BrentWilkins/rocket-workbench/docs-evidence/runs/cfd-corrected-surface-audit-20260913/report.md

# CFD pilot audit

Completed flow solution is not accepted design evidence.

Solver completed: True. Last iteration: 600. Last-100-sample settling screen: True. Zero-angle lateral/moment symmetry
screen: False.

| Coefficient | Last-100 mean | Peak-to-peak |
| --- | --- | --- |
| Cd | 0.593827 | 0.000002 |
| Cl | 0.000646 | 0.000016 |
| Cs | 0.022699 | 0.000018 |
| CmPitch | -0.002960 | 0.000088 |
| CmRoll | -0.000579 | 0.000001 |
| CmYaw | 0.102051 | 0.000085 |

Axes are taken from the solver output, not assumed from input keywords. v2512 reports pitch about negative Z for this
drag/lift basis. No coefficients have been transferred to flight models. Grid/wall/domain checks and benchmark
comparison remain outstanding.
