BrentWilkins/rocket-workbench/docs-evidence/runs/fin-recovery-stress-summary-20260913/report.md

# Full recovery uncertainty comparison

Three designs × 288 deterministic cases = 864 flights. 192 planned dummy/logger and 96 diagnostic-empty cases per
design. These are not reliability probabilities. No CFD acceptance or physical launch clearance is implied.

| Design | Planned passes / 192 | Loaded altitude m | Loaded speed m/s | Loaded descent m/s |
| --- | --- | --- | --- | --- |
| delta-chute20-body430-nominal | 192 | 154.32–193.99 | 52.72–62.00 | 4.39–5.80 |
| delta-chute22-body460-nominal | 192 | 148.99–187.64 | 51.38–60.36 | 4.04–5.33 |
| delta-chute24-body500-nominal | 192 | 142.97–180.36 | 49.89–58.51 | 3.76–4.95 |

Inputs: nominal/upper avionics, mount mass ×1/1.5, printed mass ×1/1.2, payload CG ±5 mm, chute Cd 0.6/0.9, winds 0/2/4
m/s. Canopy mass and packed volume are provisional area-scaled estimates.
