BrentWilkins/rocket-workbench/docs-evidence/runs/fin-stress-20260913/report.md

# Fin finalist uncertainty comparison

Deterministic corners, not reliability probabilities. Dummy/logger planned; empty diagnostic. No flight clearance.

| Design | Upper avionics | Mount factor | Planned pass / 48 | Failure counts |
| --- | --- | --- | --- | --- |
| [trapezoidal-a45-b430](trapezoidal-a45-b430-upper0-mount1/stress-20260913T160857Z-1c177246/report.md) | False | 1.0 | 36 | {'landing_descent_m_s': 12} |
| [trapezoidal-a45-b430](trapezoidal-a45-b430-upper0-mount1.5/stress-20260913T160922Z-8180d281/report.md) | False | 1.5 | 20 | {'landing_descent_m_s': 24, 'minimum_ascent_stability_cal': 8} |
| [trapezoidal-a45-b430](trapezoidal-a45-b430-upper1-mount1/stress-20260913T160944Z-6b664524/report.md) | True | 1.0 | 24 | {'landing_descent_m_s': 24} |
| [trapezoidal-a45-b430](trapezoidal-a45-b430-upper1-mount1.5/stress-20260913T161008Z-c6a25181/report.md) | True | 1.5 | 24 | {'landing_descent_m_s': 24} |
| [elliptical-a55-b410](elliptical-a55-b410-upper0-mount1/stress-20260913T161038Z-3ba5412f/report.md) | False | 1.0 | 36 | {'landing_descent_m_s': 12} |
| [elliptical-a55-b410](elliptical-a55-b410-upper0-mount1.5/stress-20260913T161105Z-b08634cd/report.md) | False | 1.5 | 24 | {'landing_descent_m_s': 24} |
| [elliptical-a55-b410](elliptical-a55-b410-upper1-mount1/stress-20260913T161140Z-ebfc4f2c/report.md) | True | 1.0 | 24 | {'landing_descent_m_s': 24} |
| [elliptical-a55-b410](elliptical-a55-b410-upper1-mount1.5/stress-20260913T161203Z-02ca7021/report.md) | True | 1.5 | 24 | {'landing_descent_m_s': 24} |
| [clipped-delta-a45-b410](clipped-delta-a45-b410-upper0-mount1/stress-20260913T161230Z-215af76f/report.md) | False | 1.0 | 36 | {'landing_descent_m_s': 12} |
| [clipped-delta-a45-b410](clipped-delta-a45-b410-upper0-mount1.5/stress-20260913T161255Z-e73950df/report.md) | False | 1.5 | 24 | {'landing_descent_m_s': 24} |
| [clipped-delta-a45-b410](clipped-delta-a45-b410-upper1-mount1/stress-20260913T161319Z-885b2120/report.md) | True | 1.0 | 24 | {'landing_descent_m_s': 24} |
| [clipped-delta-a45-b410](clipped-delta-a45-b410-upper1-mount1.5/stress-20260913T161342Z-355af603/report.md) | True | 1.5 | 24 | {'landing_descent_m_s': 24} |
| [clipped-delta-a45-b430](clipped-delta-a45-b430-upper0-mount1/stress-20260913T161404Z-97cb0a8c/report.md) | False | 1.0 | 36 | {'landing_descent_m_s': 12} |
| [clipped-delta-a45-b430](clipped-delta-a45-b430-upper0-mount1.5/stress-20260913T161428Z-2a7e5a03/report.md) | False | 1.5 | 24 | {'landing_descent_m_s': 24} |
| [clipped-delta-a45-b430](clipped-delta-a45-b430-upper1-mount1/stress-20260913T161452Z-0759a5cc/report.md) | True | 1.0 | 24 | {'landing_descent_m_s': 24} |
| [clipped-delta-a45-b430](clipped-delta-a45-b430-upper1-mount1.5/stress-20260913T161519Z-eef21873/report.md) | True | 1.5 | 24 | {'landing_descent_m_s': 24} |
| [swept-a45-b410](swept-a45-b410-upper0-mount1/stress-20260913T161546Z-51bf399e/report.md) | False | 1.0 | 36 | {'landing_descent_m_s': 12} |
| [swept-a45-b410](swept-a45-b410-upper0-mount1.5/stress-20260913T161616Z-b25ae19c/report.md) | False | 1.5 | 24 | {'landing_descent_m_s': 24} |
| [swept-a45-b410](swept-a45-b410-upper1-mount1/stress-20260913T161640Z-08345981/report.md) | True | 1.0 | 24 | {'landing_descent_m_s': 24} |
| [swept-a45-b410](swept-a45-b410-upper1-mount1.5/stress-20260913T161708Z-79132db7/report.md) | True | 1.5 | 24 | {'landing_descent_m_s': 24} |
