BrentWilkins/rocket-workbench/docs-evidence/runs/insert-wide-summary-20260913/report.md

# Expanded recovery uncertainty comparison

288 deterministic flights; 192 planned dummy/logger and 96 empty diagnostics per design. Scenario counts are not
reliability probabilities.

Bounds: print mass ×1/1.2, payload CG ±5 mm, wind 0/2/4 m/s, chute Cd 0.53/1.04, mount mass ×1/1.5. Upper avionics and
+20% chute mass are paired, not independently varied. Generic packing remains provisional; sourced chute mass is a
literature specimen, not our hardware.

| Design | Planned passes / 192 | Altitude m | Speed m/s | Descent m/s | Drift m |
| --- | --- | --- | --- | --- | --- |
| apogee24-body500-heavy0-cd053-insert-trial | 192 | 144.64–186.62 | 50.33–60.29 | 3.45–5.24 | 0.04–163.02 |

Drift is horizontal landing displacement from the pad under the modeled uniform winds. It is not a landing-zone
guarantee. CFD, final retention hardware and physical validation remain separate.

Insert-trial upper profiles add 0.7 g to the nominal joint allowance, paired with upper avionics/chute mass. These are
unmeasured engineering allowances, not tested joint strength.
