BrentWilkins/rocket-workbench/docs-evidence/runs/ring-tail-geometry-step-20260913/report.md

# Ring-tail geometry comparison

Experimental 1.2 mm wall rings joining three clipped-delta tips. No flight-performance ranking, structural qualification
or print release. Native planar OpenRocket models do not represent the ring.

| Candidate | Added mass g | First-layer area mm² | Fits 236 mm square |
| --- | --- | --- | --- |
| planar-baseline | 0.000 | 420.4 | True |
| ring-tail-5mm | 3.551 | 993.2 | True |
| ring-tail-10mm  | 7.102 | 993.2 | True |

Mass is a CAD-density estimate. Ring area increases bed contact, but does not establish adhesion, impact tolerance or
aerodynamic benefit. External CFD and force/moment validation remain required.
