BrentWilkins/rocket-workbench/docs-evidence/runs/avionics-baseline-stress-20260913/report.md

# Current-avionics finalist uncertainty comparison

Each row: print mass 1.0/1.2, payload CG -5/+5 mm, chute Cd 0.6/0.9, winds 0/2/4 m/s, three loadings. Nominal and upper
avionics budgets are separate. Corner counts are not reliability probabilities.

| Design | Avionics g | Cases meeting gates | Loaded apogee range m | Loaded speed range m/s |
| --- | --- | --- | --- | --- |
| [conical-n50-b410-f55](conical-n50-b410-f55-nominal/stress-20260913T040714Z-27042adb/report.md) | 20.65 | 36/72 | 40.39–57.18 | 18.95–22.41 |
| [conical-n50-b410-f55](conical-n50-b410-f55-upper/stress-20260913T040736Z-ead8ec46/report.md) | 29.2 | 28/72 | 35.86–51.82 | 17.60–20.74 |
