BrentWilkins/rocket-workbench/docs-evidence/runs/fin-recovery-20260913/delta-chute24-body500-heavy/report.md

# Rocket Workbench report

Run: `delta-chute24-body500-heavy`

Provisional software demonstration. Physical assembly and flight validation are pending.

Configuration SHA256: `9ba0babb481d0958b2b8f0ed924b388f39b222cae05539b1101e2dd6c79a7ab2`

## Cases

| Case | Execution / evaluation | Apogee m | Guide m/s | Min ascent cal | Deploy m/s | Descent m/s | Drift m | Powered accel g | Estimated load g | Powered speed m/s |
| --- | --- | ---: | ---: | ---: | ---: | ---: | ---: | ---: | ---: | ---: |
| empty-D12-5-wind0  | completed / incomplete inputs | 178.85 | 12.83 | 1.82 | 2.56 | 4.62 | 0.08 | 12.95 | 13.95 | 58.09 |
| empty-D12-5-wind2  | completed / incomplete inputs | 177.09 | 12.82 | 1.14 | 3.66 | 4.62 | 53.05 | 12.94 | 13.94 | 57.95 |
| empty-D12-5-wind4  | completed / incomplete inputs | 172.39 | 12.82 | 1.16 | 6.42 | 4.62 |  105.32 | 12.93 | 13.93 | 57.56 |
| dummy-D12-5-wind0  | completed / incomplete inputs | 150.40 | 12.30 | 2.66 | 6.05 | 4.95 | 0.04 | 11.30 | 12.30 | 50.46 |
| dummy-D12-5-wind2  | completed / incomplete inputs | 148.43 | 12.30 | 2.02 | 6.71 | 4.95 | 33.34 | 11.29 | 12.29 | 50.31 |
| dummy-D12-5-wind4  | completed / incomplete inputs | 142.97 | 12.30 | 1.82 | 9.87 | 4.95 | 64.41 | 11.29 | 12.29 | 49.89 |
| actual-D12-5-wind0 | completed / incomplete inputs | 150.40 | 12.30 | 2.66 | 6.05 | 4.95 | 0.04 | 11.30 | 12.30 | 50.46 |
| actual-D12-5-wind2 | completed / incomplete inputs | 148.43 | 12.30 | 2.02 | 6.71 | 4.95 | 33.34 | 11.29 | 12.29 | 50.31 |
| actual-D12-5-wind4 | completed / incomplete inputs | 142.97 | 12.30 | 1.82 | 9.87 | 4.95 | 64.41 | 11.29 | 12.29 | 49.89 |

No case is ranked or cleared for flight. Dummy and provisional actual loads use the same mass and CG.

## Warnings and failures

- empty-D12-5-wind0: no engine warnings
- empty-D12-5-wind2: no engine warnings
- empty-D12-5-wind4: no engine warnings
- dummy-D12-5-wind0: no engine warnings
- dummy-D12-5-wind2: no engine warnings
- dummy-D12-5-wind4: no engine warnings
- actual-D12-5-wind0: no engine warnings
- actual-D12-5-wind2: no engine warnings
- actual-D12-5-wind4: no engine warnings

## Missing measurements / physical checks

- Measured mass and balance: BT-60 cardboard airframe
- Measured mass and balance: Provisional commercial 24 mm mount assembly plus CD spacer
- Measured mass and balance: Provisional 24 inch parachute and lines
- Measured mass and balance: Kevlar leader, elastic harness, swivel and knots
- Measured mass and balance: Recovery wadding
- Measured mass and balance: Two paper launch lugs and adhesive
- Measured mass and balance: Bulkhead eye bolt, washers, nuts, sled screws and cable ties
- Measured mass and balance: Fin collar adhesive and tapered lip fillet
- Measured mass and balance: Flame-resistant bay shield and perimeter seal allowance
- Assembled mass/CG, print fit, attachment strength and recovery separation checks
- V2 saddle bond strength and adhesive mass require physical checks; saddle-specific aerodynamic drag is unresolved
- Avionics board/antenna/battery masses, stack clearances, retention, wiring and power must be measured; vendor CAD is
  not physical validation
- Static-port drilling/alignment, bulkhead and screw seals, pressure lag and aerodynamic pressure bias require
  bench/flight validation

## Per-case criterion failures

- empty-D12-5-wind0: no numeric criterion failures; consult warnings and missing inputs
- empty-D12-5-wind2: no numeric criterion failures; consult warnings and missing inputs
- empty-D12-5-wind4: no numeric criterion failures; consult warnings and missing inputs
- dummy-D12-5-wind0: no numeric criterion failures; consult warnings and missing inputs
- dummy-D12-5-wind2: no numeric criterion failures; consult warnings and missing inputs
- dummy-D12-5-wind4: no numeric criterion failures; consult warnings and missing inputs
- actual-D12-5-wind0: no numeric criterion failures; consult warnings and missing inputs
- actual-D12-5-wind2: no numeric criterion failures; consult warnings and missing inputs
- actual-D12-5-wind4: no numeric criterion failures; consult warnings and missing inputs

## Assumptions and boundaries

- Length origin: nose tip, +x aft; CAD +Z maps to axial +x. Flight position: OpenRocket local east/north/up, SI units.
- ISA atmosphere, constant wind at every height, zero turbulence; configured seed is retained. Displacement is
  scenario-dependent.
- Native OpenRocket aerodynamics; configured axisymmetric nose, cylindrical sections, three flat trapezoidal fins and
  tapered collar fairing. The thin fairing lip/glue fillet is an approximation documented in BUILD.md.
- CAD volume × material density is a solid-mass estimate. Nose/bay/sled lumped mass and CG; fin mass included once in
  collar override.
- No external camera/antenna is modeled. Configuration rejects protrusions. An internal camera has no guaranteed useful
  view.
- Stability minimum is sampled from guide departure strictly before apogee or deployment, whichever comes first, using
  (CP−CG)/reference diameter. Low-speed samples remain included; time, speed and angle at the minimum are in JSON.
- Event metrics interpolate adjacent samples at the engine event time. Landing descent is vertical speed at ground
  event, not a structural impact assessment.
- Powered peaks use positive-thrust samples from liftoff strictly before first burnout, deployment, abort or ground
  contact. Missing events/data yield unavailable metrics; peak times and sample coverage are in JSON. These are sampled
  single-stage maxima, not continuous-time bounds.
- Powered acceleration is trajectory acceleration magnitude / 9.80665. Estimated load is hypot(lateral acceleration,
  vertical acceleration + local gravity) / 9.80665 at the center of mass. Coriolis correction, sensor-offset rotation,
  vibration and deployment/impact shock are excluded; this is not a per-axis IMU prediction or a hardware survival
  rating.
- Recovery is motor-ejection deployment with configured Cd; packing envelope, ejection seal, thermal protection and
  attachment loads require physical checks.
- Reference mode preserves upstream geometry and masses; demonstration CAD and baseline mass assumptions do not apply to
  that reference.

## Configured criteria

- apogee_m: 30.0 … None m; engineering assumption; New motor comparison: report altitude without inherited 120 m
  ceiling; retain 30 m minimum. Site altitude clearance is unassessed.
- guide_departure_m_s: 12.0 … None m/s; engineering assumption; Project engineering assumption for demonstration
  screening; not a launch clearance
- minimum_ascent_stability_cal: 1.0 … None cal; engineering assumption; Project engineering assumption for demonstration
  screening; not a launch clearance
- deployment_speed_m_s: None … 10.0 m/s; engineering assumption; Project engineering assumption for demonstration
  screening; not a launch clearance
- landing_descent_m_s: None … 6.0 m/s; engineering assumption; Project engineering assumption for demonstration
  screening; not a launch clearance

## Reproducibility

```json
{
  "openrocket": "24.12",
  "java": "21.0.3+7-LTS-152",
  "python": "3.14.6",
  "bridge_revision": "fb132c49e661bb00c5586cce6a4ac0c655425197",
  "jar_sha256": "4959b72f52f5f607941e9722abbb7b7f0c4a38ebbbf84204a329db9f31c4f897",
  "packages": {
    "orhelper": "0.1.5",
    "jpype1": "1.7.1",
    "numpy": "2.5.3",
    "pydantic": "2.13.5",
    "cadquery": "2.8.0"
  },
  "repository_revision": "2ca06e7f9c7adcd40d8e6847452df77f6a5b9717"
}
```

Exact motor curves, events and time series are retained in results.json. Null means unavailable; failures remain in the
table.
