BrentWilkins/rocket-workbench/docs-evidence/runs/avionics-geometry-20260913-corrected/conical-n50-b440-f55/report.md

# Rocket Workbench report

Run: `conical-n50-b440-f55`

Provisional software demonstration. Physical assembly and flight validation are pending.

Configuration SHA256: `02cb2b9dbd6d32880f0f9e05b9cc578a8937dd832cbc38b06a19166e590f08de`

## Cases

| Case | Execution / evaluation | Apogee m | Guide m/s | Min ascent cal |  Deploy m/s | Descent m/s | Drift m | Powered accel g | Estimated load g | Powered speed m/s |
| --- | --- | ---: | ---: | ---: | ---: | ---: | ---: | ---: | ---: | ---: |
| empty-A8-3-wind0  | completed / outside configured limits | 7.18 | 6.64 | 2.40 | unavailable | 10.74 | 0.34 | 5.36 | 6.36 | 8.43 |
| empty-A8-3-wind2  | completed / outside configured limits | 7.13 | 6.63 | 1.19 | unavailable | 10.08 | 0.24 | 5.36 | 6.36 | 8.40 |
| empty-B4-4-wind0  | completed / outside configured limits | 25.06 | 8.34 | 1.98 | 16.35 | 5.23 | 0.47 | 7.19 | 8.19 | 17.16 |
| empty-B4-4-wind2  | completed / outside configured limits | 24.21 | 8.33 | 1.35 | 20.19 | 15.13 | 9.70 | 7.19 | 8.19 | 16.92 |
| empty-C6-3-wind0  | completed / outside configured limits | 87.22 | 9.10 | 2.23 | 1.07 | 4.82 | 0.04 | 7.83 | 8.83 | 34.62 |
| empty-C6-3-wind2  | completed / outside configured limits | 83.17 | 9.09 | 1.62 | 6.19 | 4.82 | 5.53 | 7.83 | 8.83 | 34.45 |
| empty-C6-5-wind0  | completed / outside configured limits | 87.22 | 9.10 | 1.34 | 13.15 | 4.82 | 0.38 | 7.83 | 8.83 | 34.62 |
| empty-C6-5-wind2  | completed / outside configured limits | 83.17 | 9.09 | 1.62 | 19.21 | 4.82 | 13.59 | 7.83 | 8.83 | 34.45 |
| empty-C5-3-wind0  | completed / incomplete inputs | 71.18 | 13.05 | 2.05 | 4.84 | 4.83 | 0.00 | 11.84 | 12.84 | 26.59 |
| empty-C5-3-wind2  | completed / incomplete inputs | 69.41 | 13.05 | 1.68 | 5.94 | 4.83 | 11.02 | 11.83 | 12.83 | 26.42 |
| dummy-A8-3-wind0  | completed / outside configured limits | 5.26 | 5.71 | 2.84 | unavailable | 9.81 | 0.15 | 4.62 | 5.62 | 6.77 |
| dummy-A8-3-wind2  | completed / outside configured limits | 5.25 | 5.71 | 1.72 | unavailable | 9.34 | 0.24 | 4.62 | 5.62 | 6.76 |
| dummy-B4-4-wind0  | completed / outside configured limits | 18.97 | 7.37 | 2.84 | unavailable | 16.27 | 0.81 | 6.25 | 7.25 | 14.18 |
| dummy-B4-4-wind2  | completed / outside configured limits | 18.20 | 7.37 | 1.99 | unavailable | 18.08 | 8.19 | 6.25 | 7.25 | 13.93 |
| dummy-C6-3-wind0  | completed / outside configured limits | 69.77 | 8.16 | 2.66 | 2.47 | 5.14 | 0.03 | 6.84 | 7.84 | 29.38 |
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
