BrentWilkins/rocket-workbench/docs/assets/500-ogive-review/500-ogive-fin-detail.png

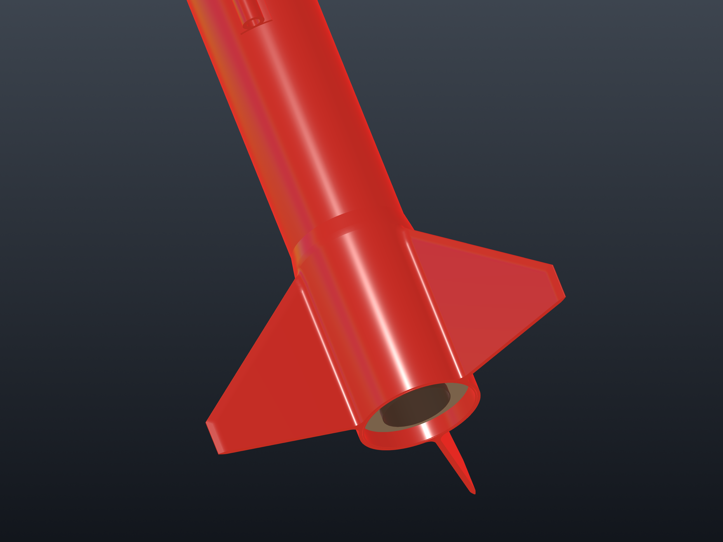
docs/assets/500-ogive-review/500-ogive-fin-detail.png
