BrentWilkins/rocket-workbench/docs/assets/500-ogive-review/500-ogive-streamlines-5120x1440.png

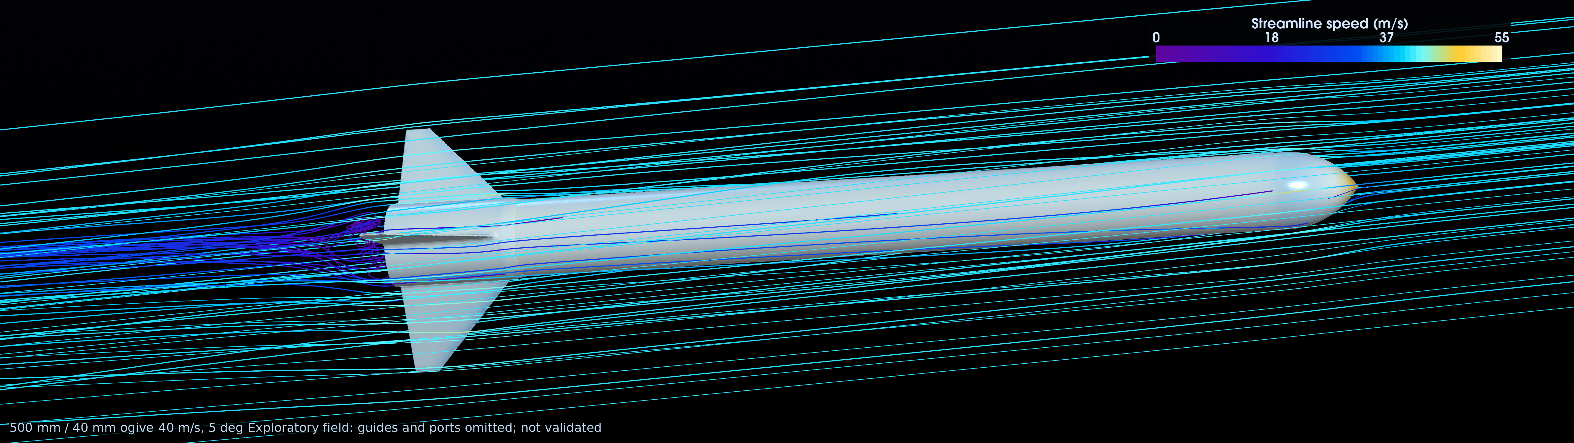
docs/assets/500-ogive-review/500-ogive-streamlines-5120x1440.png
