BrentWilkins/rocket-workbench/docs/assets/avionics/exploded.png

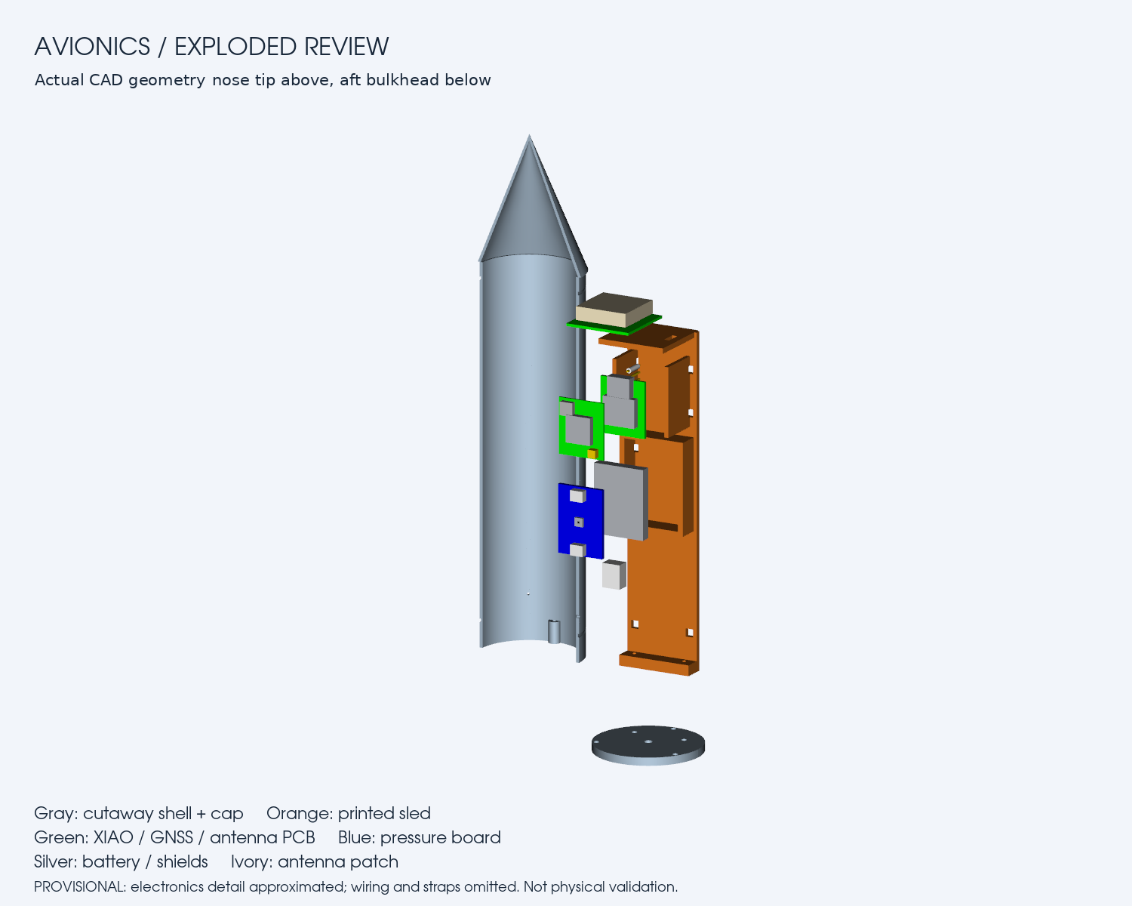
docs/assets/avionics/exploded.png
