BrentWilkins/rocket-workbench/docs/assets/cfd/swept-fin-desktop-hero.webp

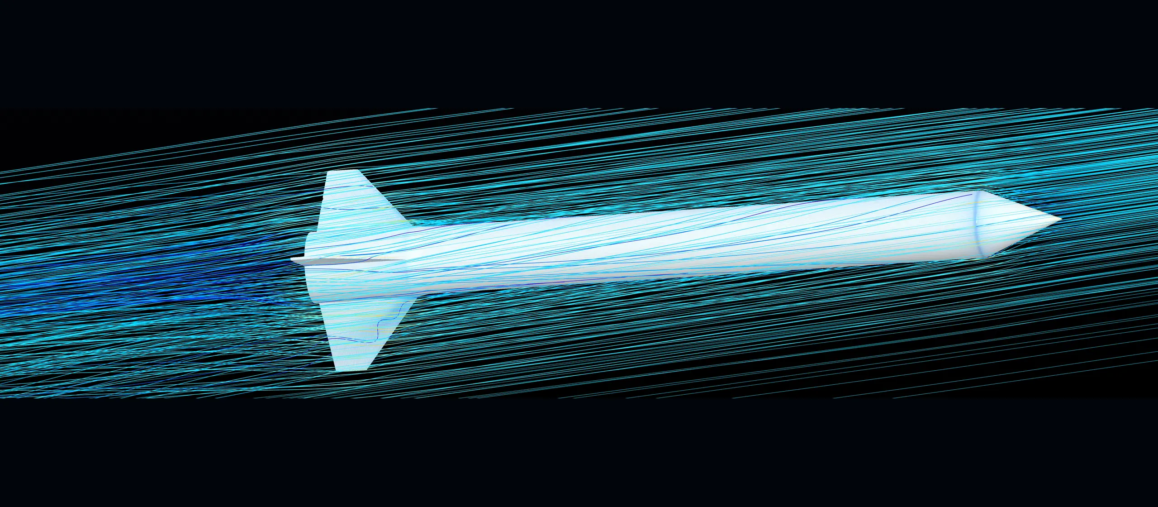
docs/assets/cfd/swept-fin-desktop-hero.webp
