BrentWilkins/rocket-workbench/docs/assets/fin-collar-v2/fin-collar-v2-review.png

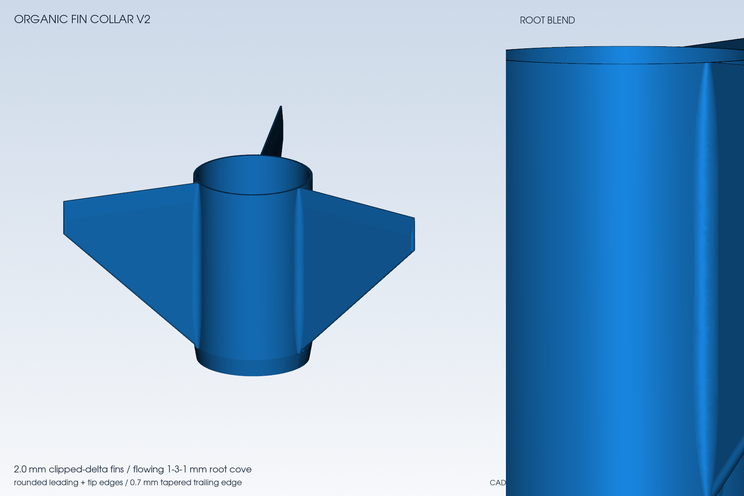
docs/assets/fin-collar-v2/fin-collar-v2-review.png
