BrentWilkins/rocket-workbench/docs/assets/flight-robustness/convergence.png

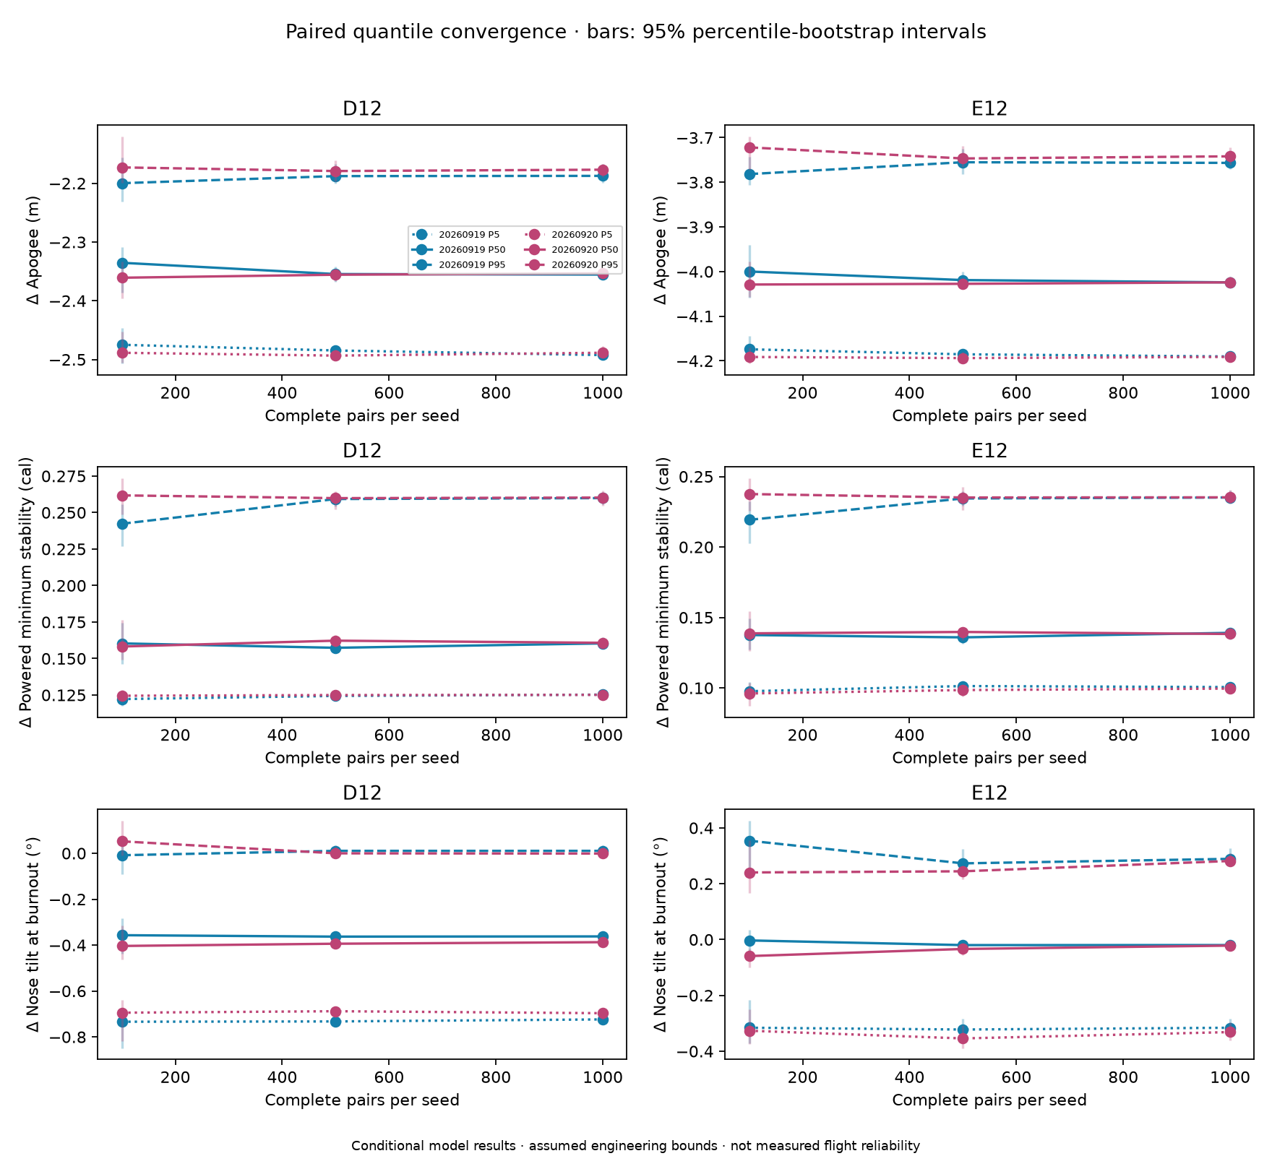
docs/assets/flight-robustness/convergence.png
