BrentWilkins/rocket-workbench/docs/assets/flight-robustness/deterministic.png

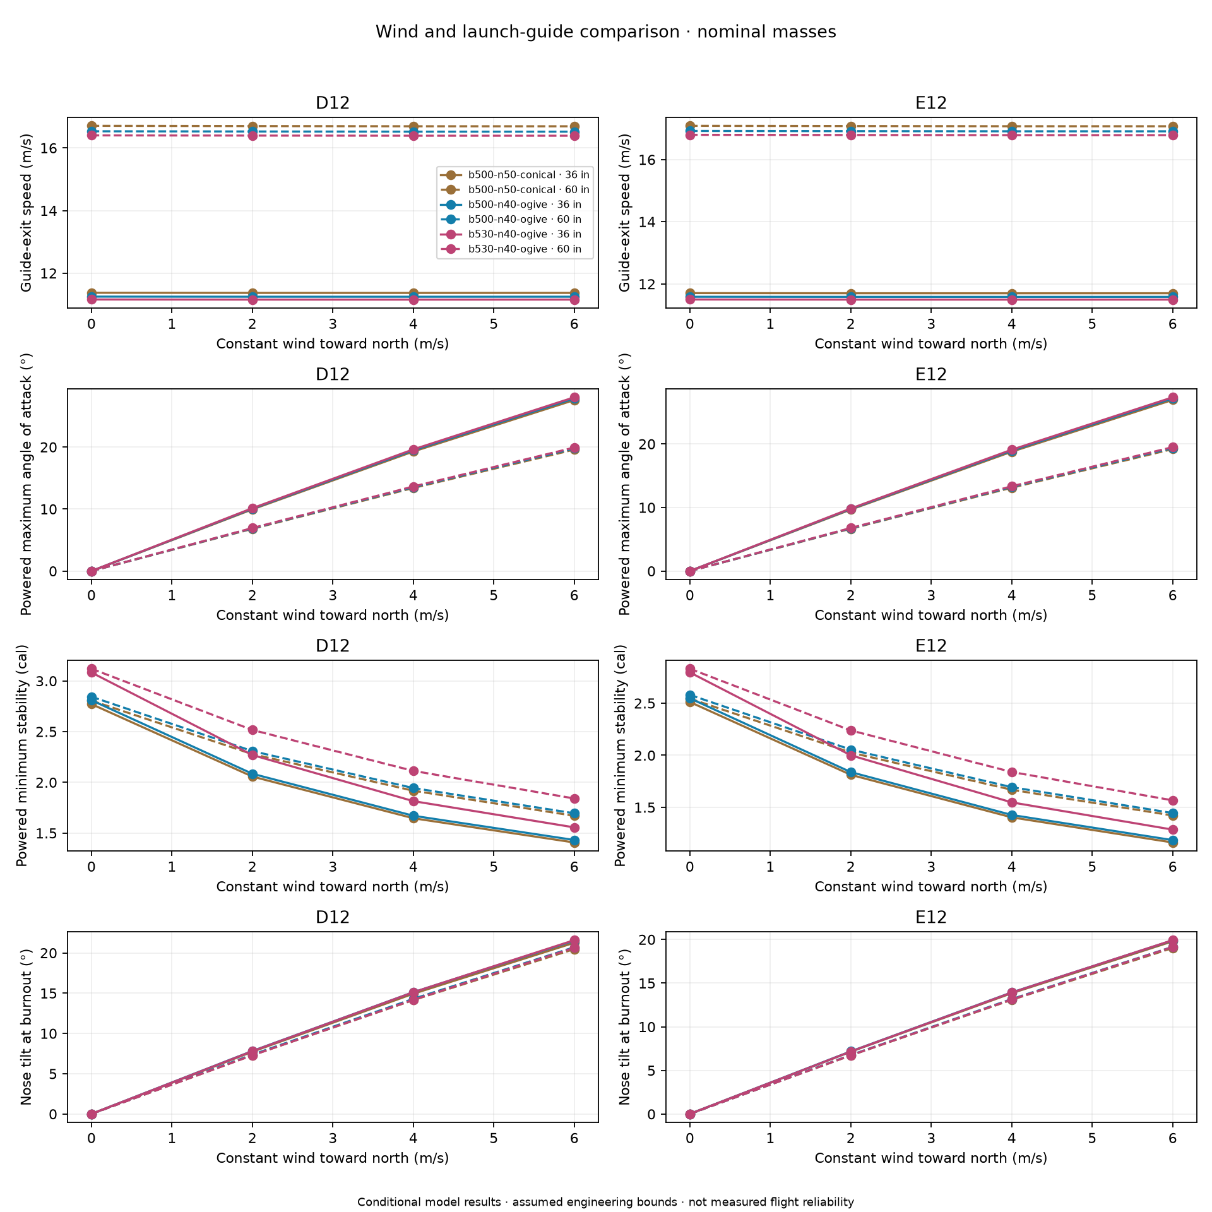
docs/assets/flight-robustness/deterministic.png
