BrentWilkins/rocket-workbench/docs/assets/flight-robustness/landing.png

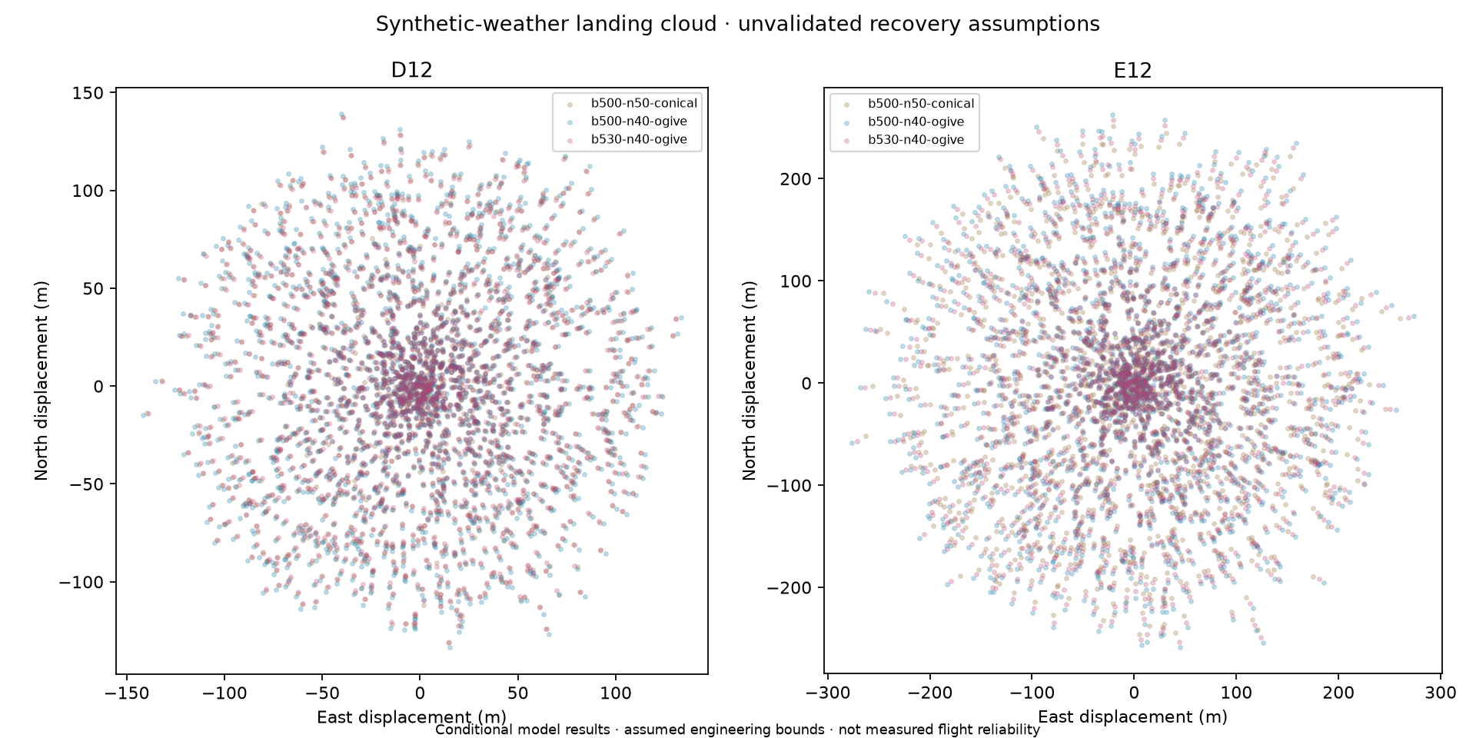
docs/assets/flight-robustness/landing.png
