BrentWilkins/rocket-workbench/docs/assets/flight-robustness/paired-differences.png

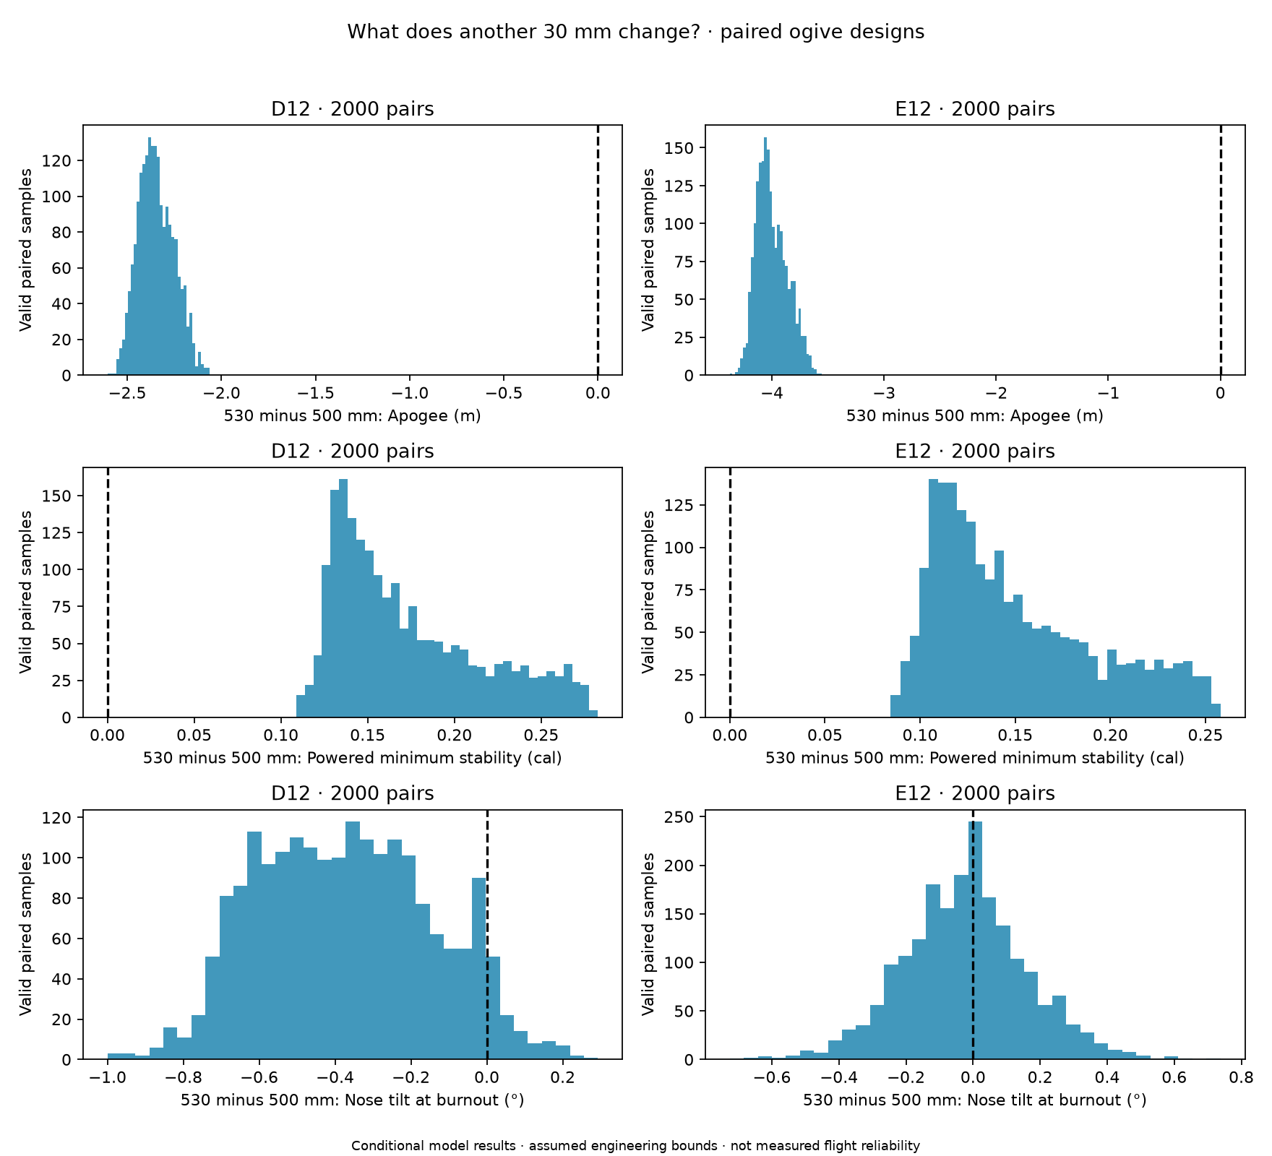
docs/assets/flight-robustness/paired-differences.png
