BrentWilkins/rocket-workbench/docs/assets/flight-robustness/paired-sensitivity.png

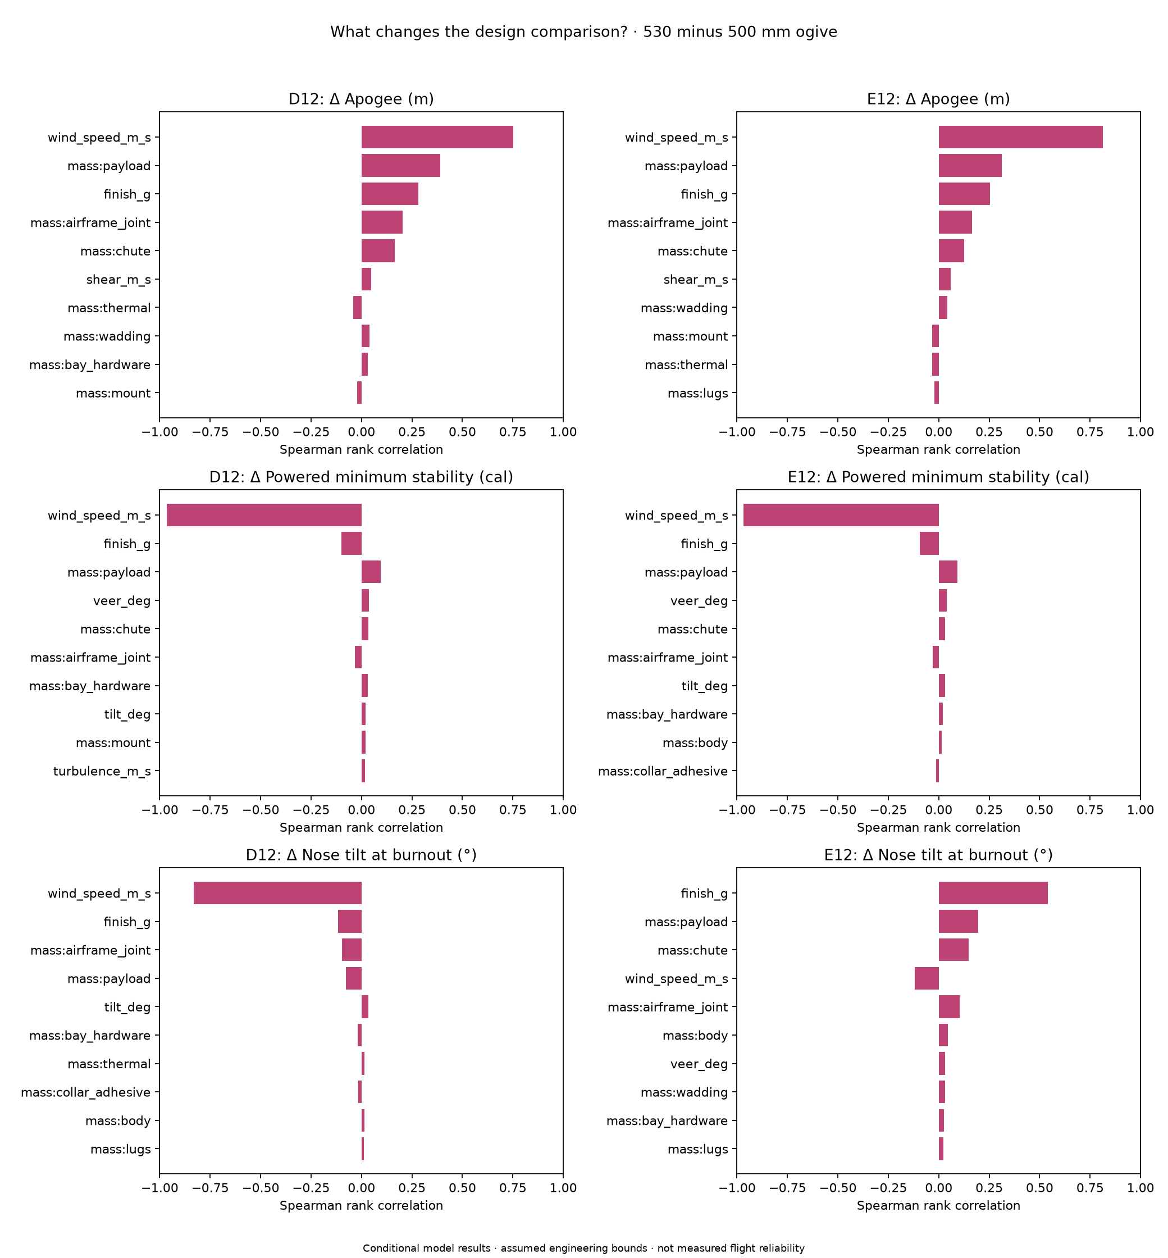
docs/assets/flight-robustness/paired-sensitivity.png
