BrentWilkins/rocket-workbench/docs/assets/flight-robustness/rocketpy-crosscheck.png

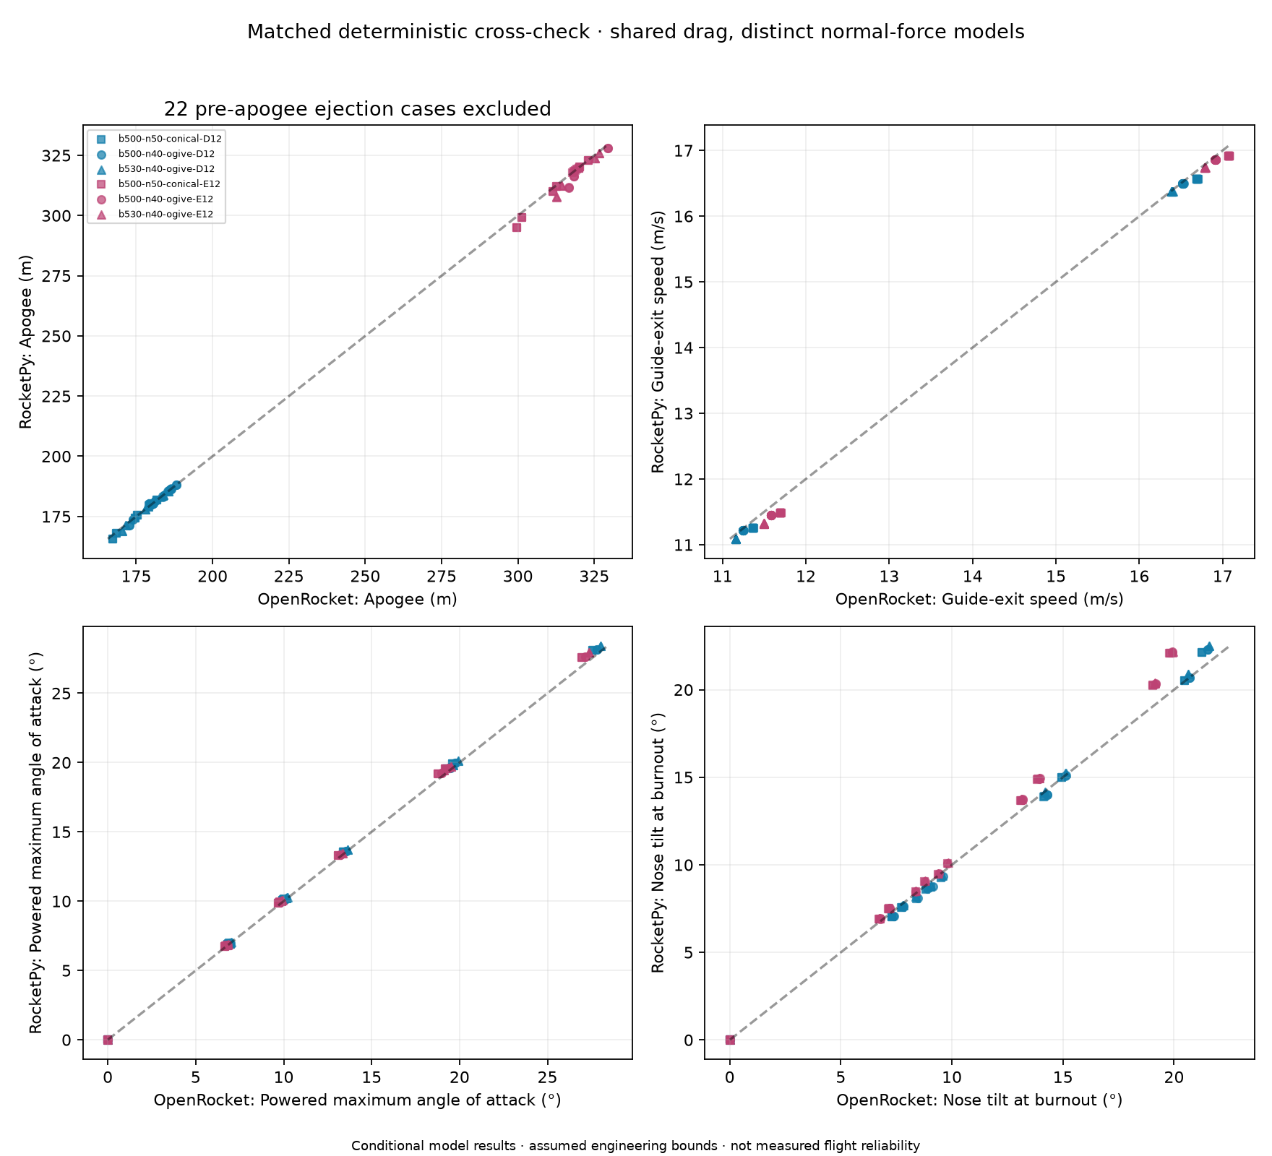
docs/assets/flight-robustness/rocketpy-crosscheck.png
