BrentWilkins/rocket-workbench/docs/assets/flight-robustness/sensitivity.png

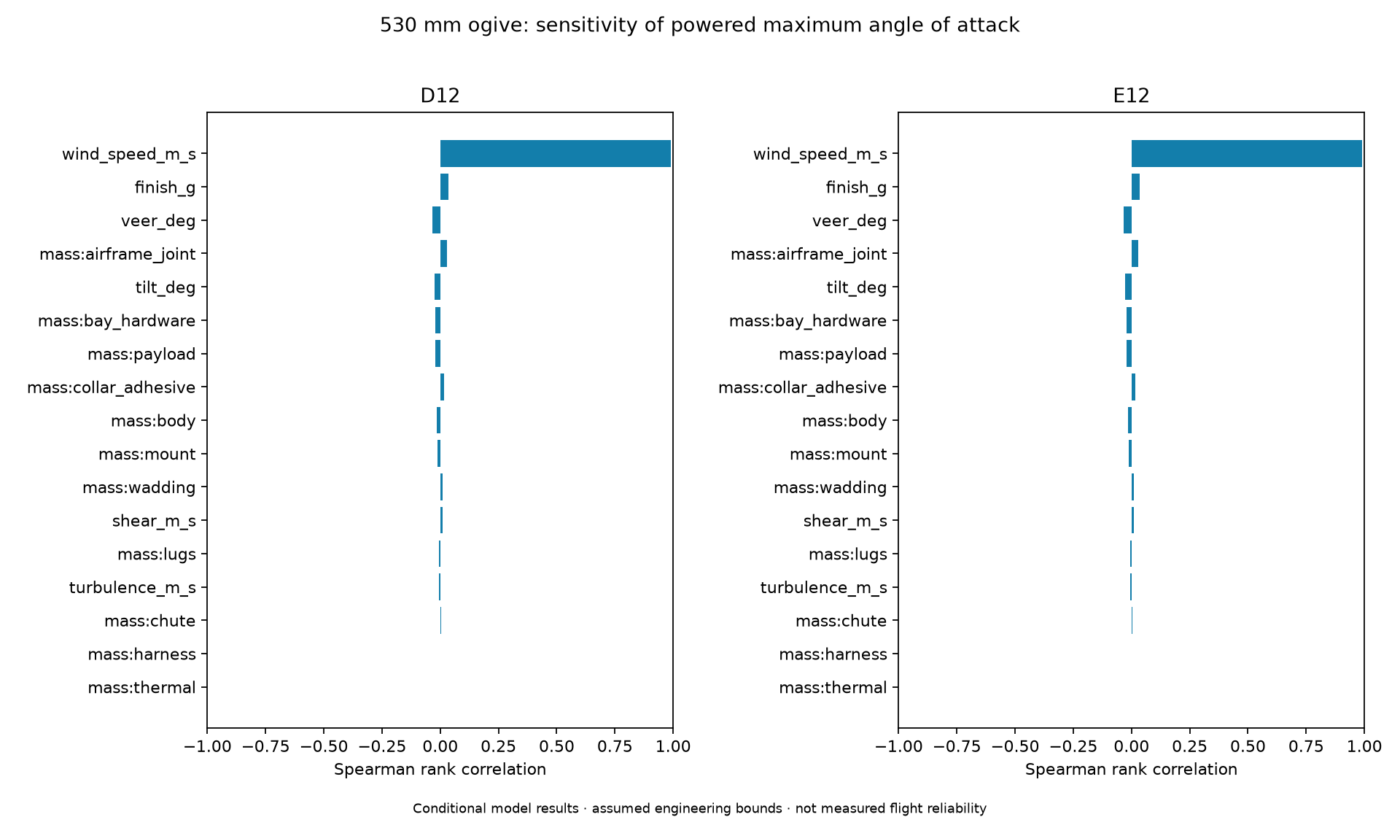
docs/assets/flight-robustness/sensitivity.png
