BrentWilkins/rocket-workbench/docs/assets/integrated-fin-collar-v1/integrated-fin-collar-preview.png

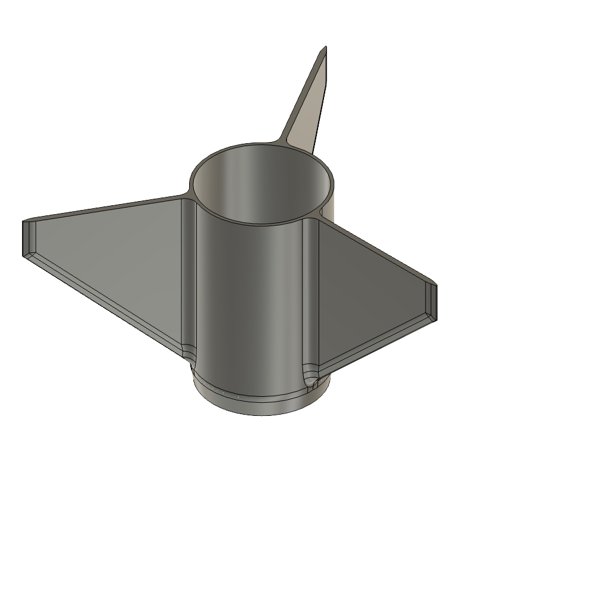
docs/assets/integrated-fin-collar-v1/integrated-fin-collar-preview.png
