BrentWilkins/rocket-workbench/docs/assets/payload-sweep/altitude-stability.png

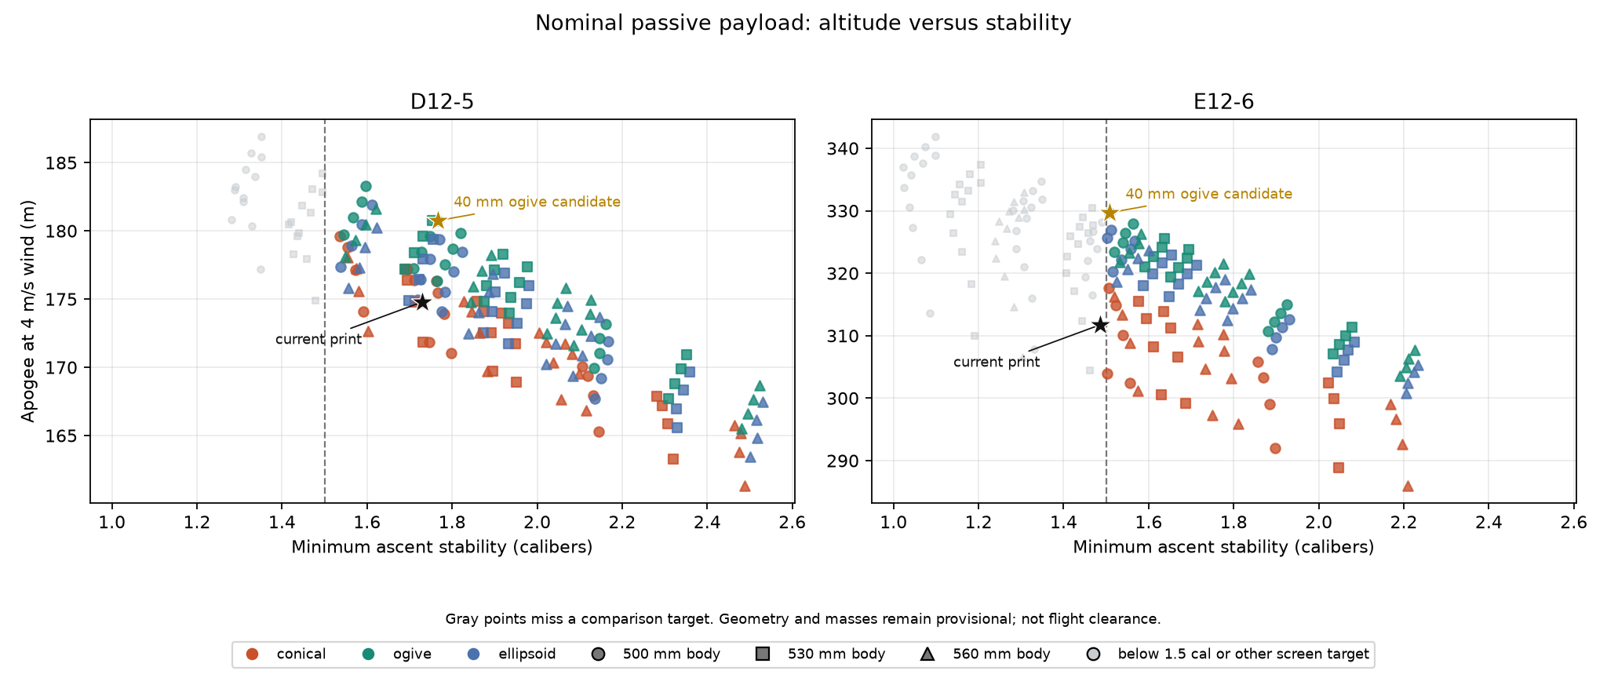
docs/assets/payload-sweep/altitude-stability.png
