BrentWilkins/rocket-workbench/docs/assets/payload-sweep/e12-geometry-map.png

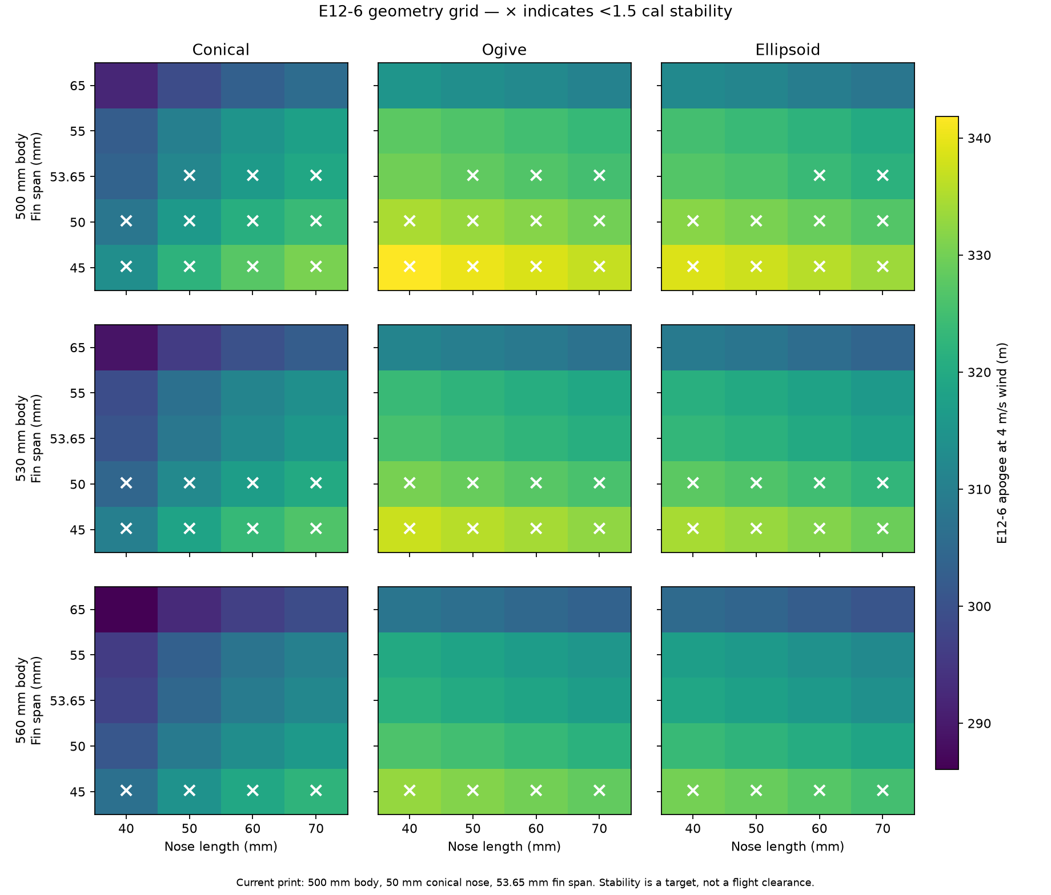
docs/assets/payload-sweep/e12-geometry-map.png
