BrentWilkins/rocket-workbench/docs/assets/payload-sweep/finished-mass-margins.png

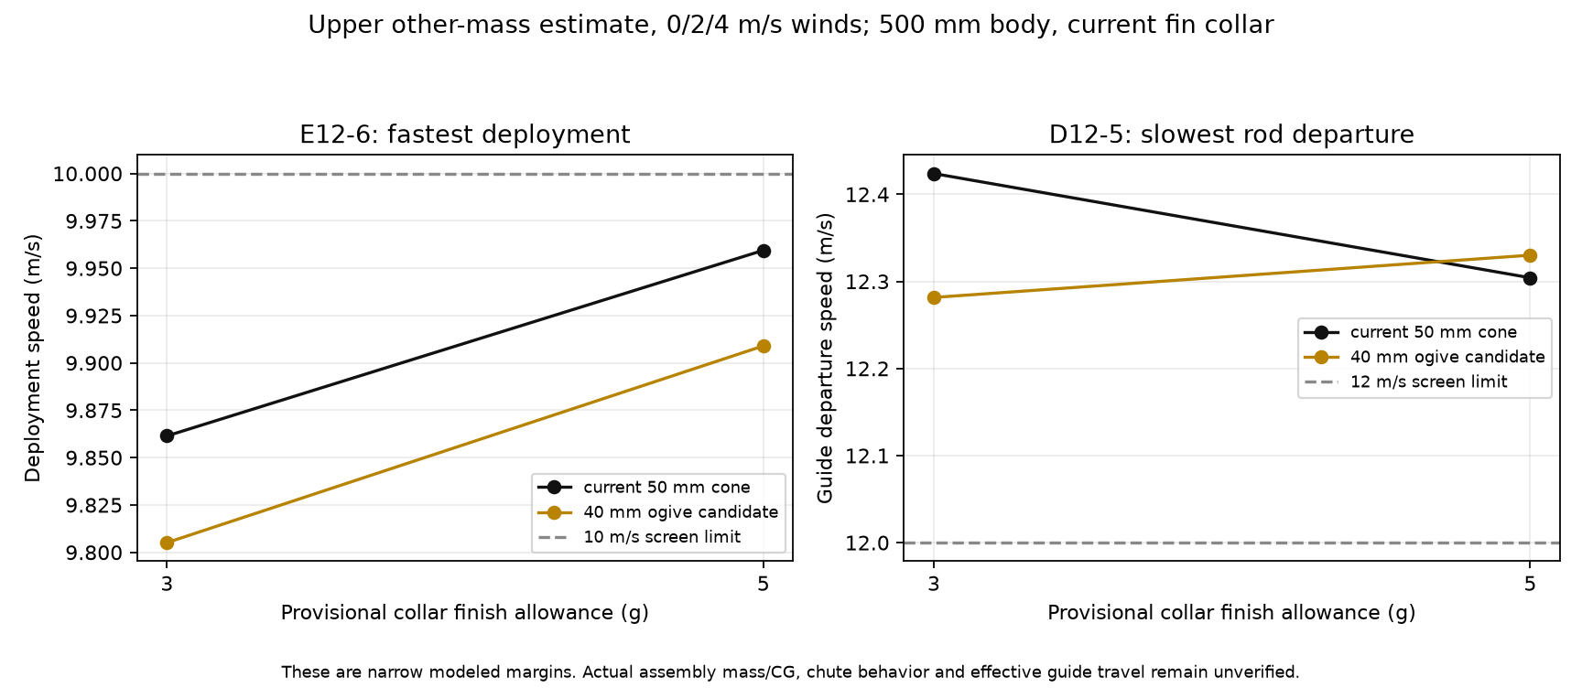
docs/assets/payload-sweep/finished-mass-margins.png
