BrentWilkins/rocket-workbench/docs/assets/payload-sweep/forward-additions.png

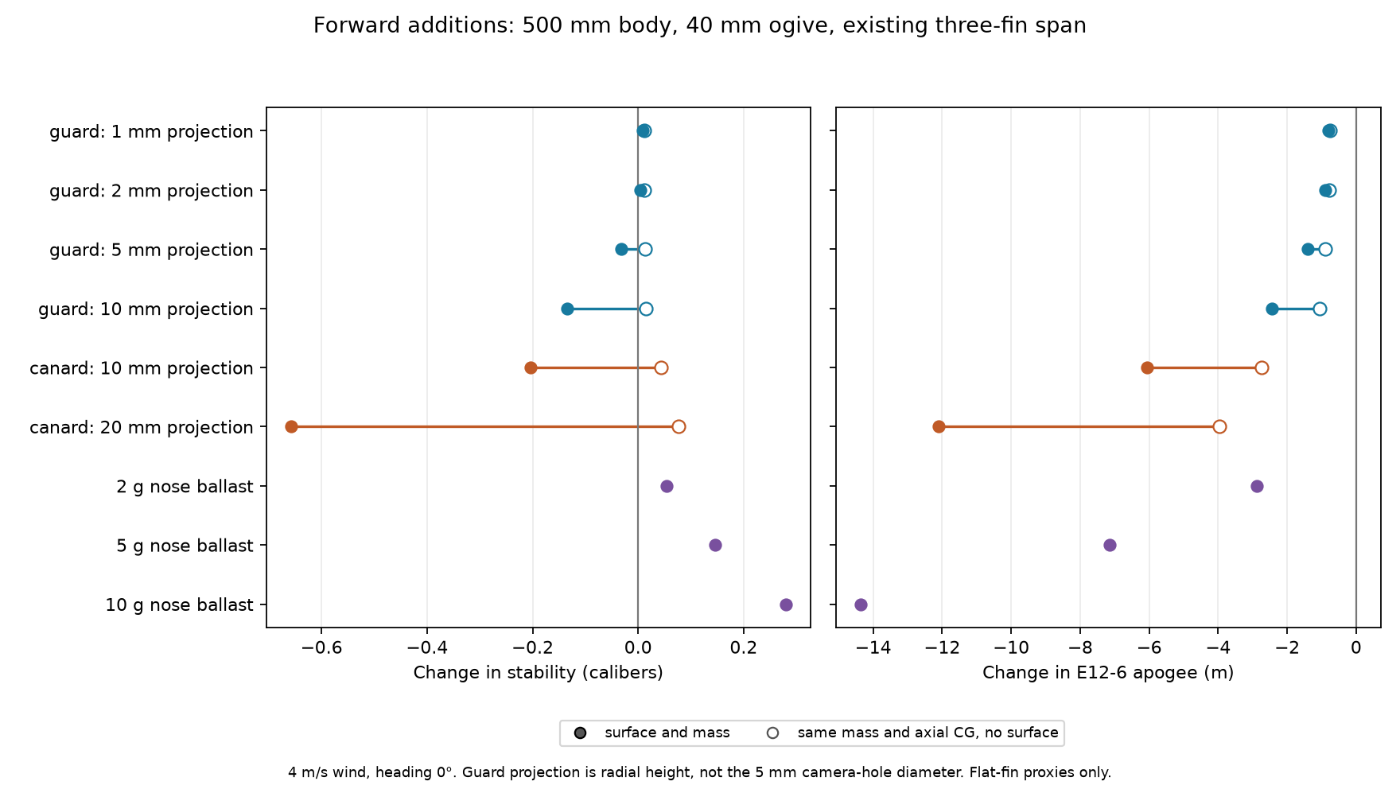
docs/assets/payload-sweep/forward-additions.png
