BrentWilkins/rocket-workbench/docs/assets/payload-sweep/nose-profiles.png

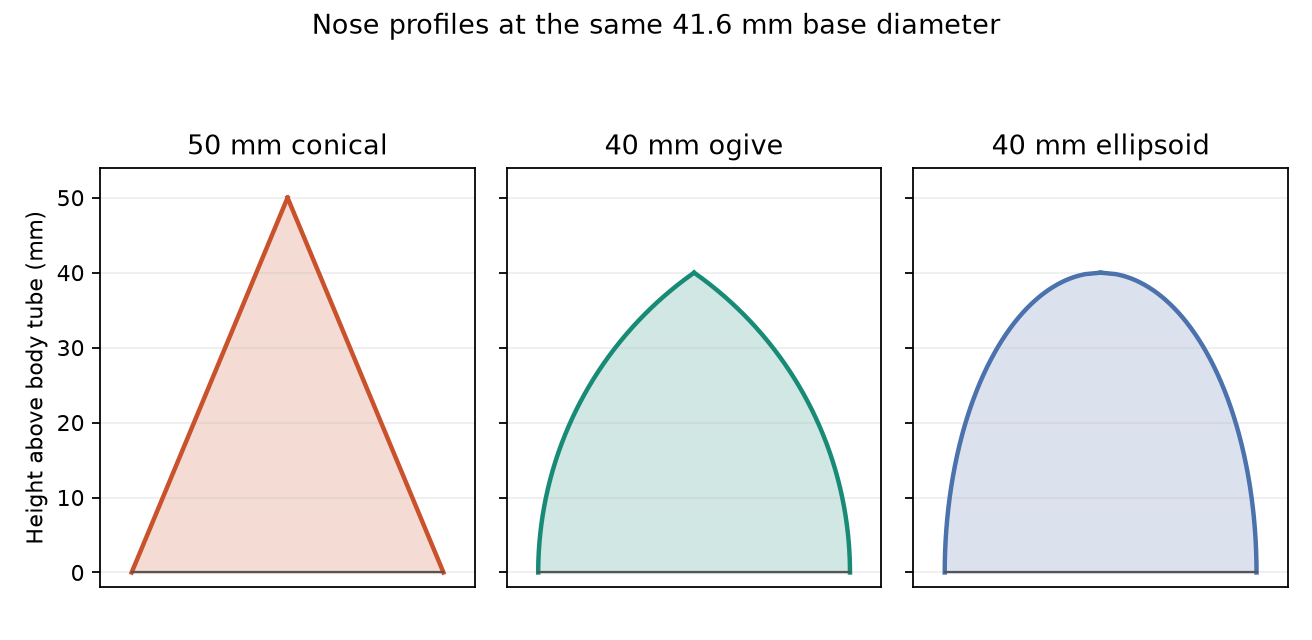
docs/assets/payload-sweep/nose-profiles.png
