BrentWilkins/rocket-workbench/docs/assets/payload-sweep/three-vs-four-fins.png

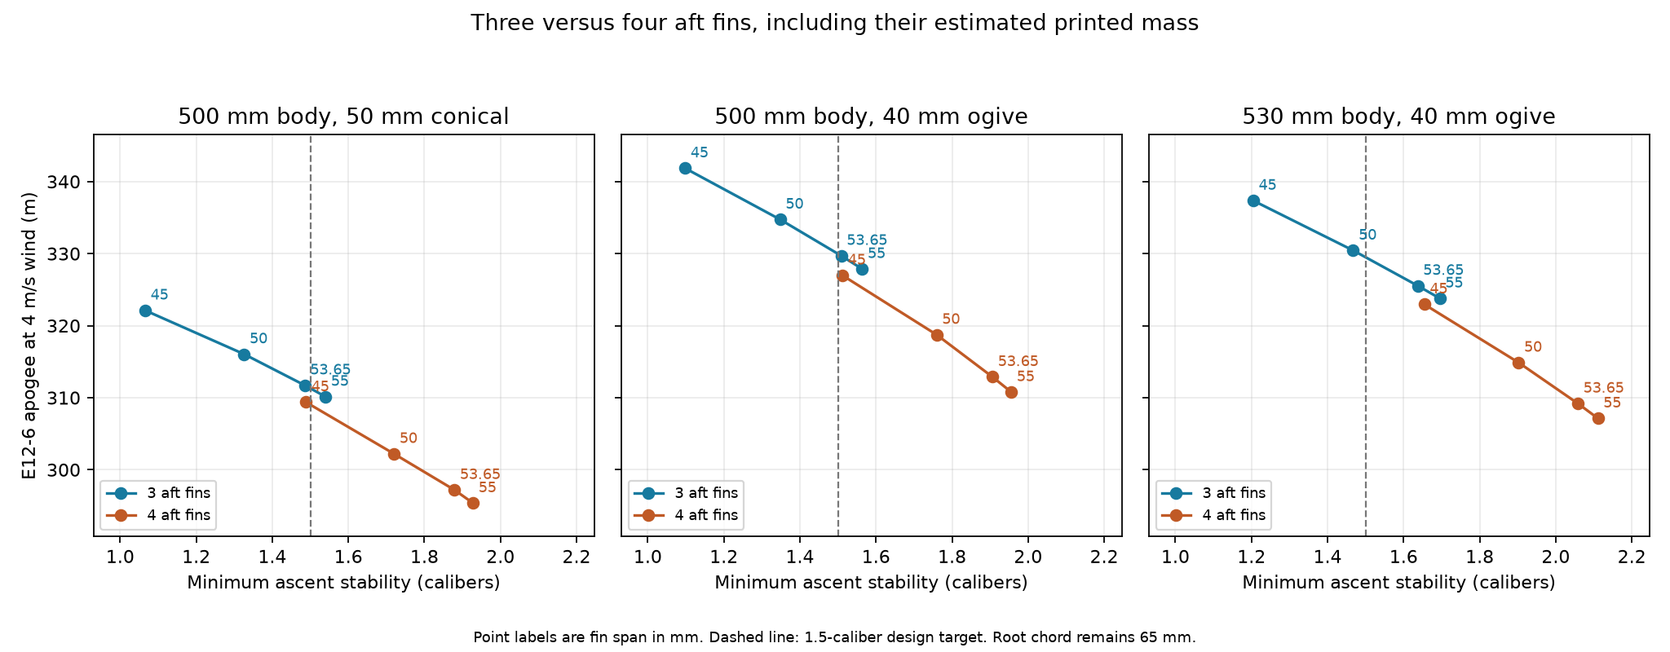
docs/assets/payload-sweep/three-vs-four-fins.png
