BrentWilkins/rocket-workbench/plots/de-geometry-same-motor.png

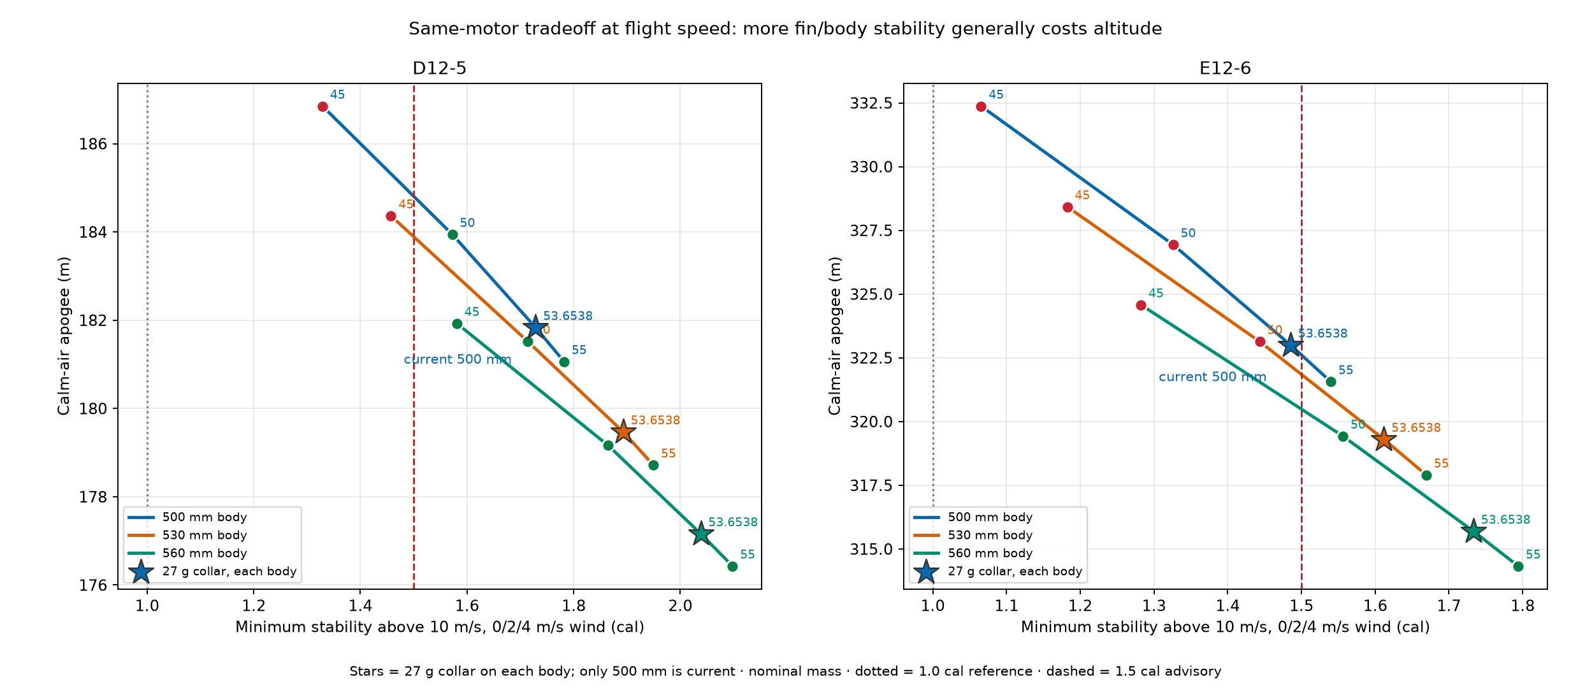
plots/de-geometry-same-motor.png
