BrentWilkins/rocket-workbench/plots/de-geometry-surface.png

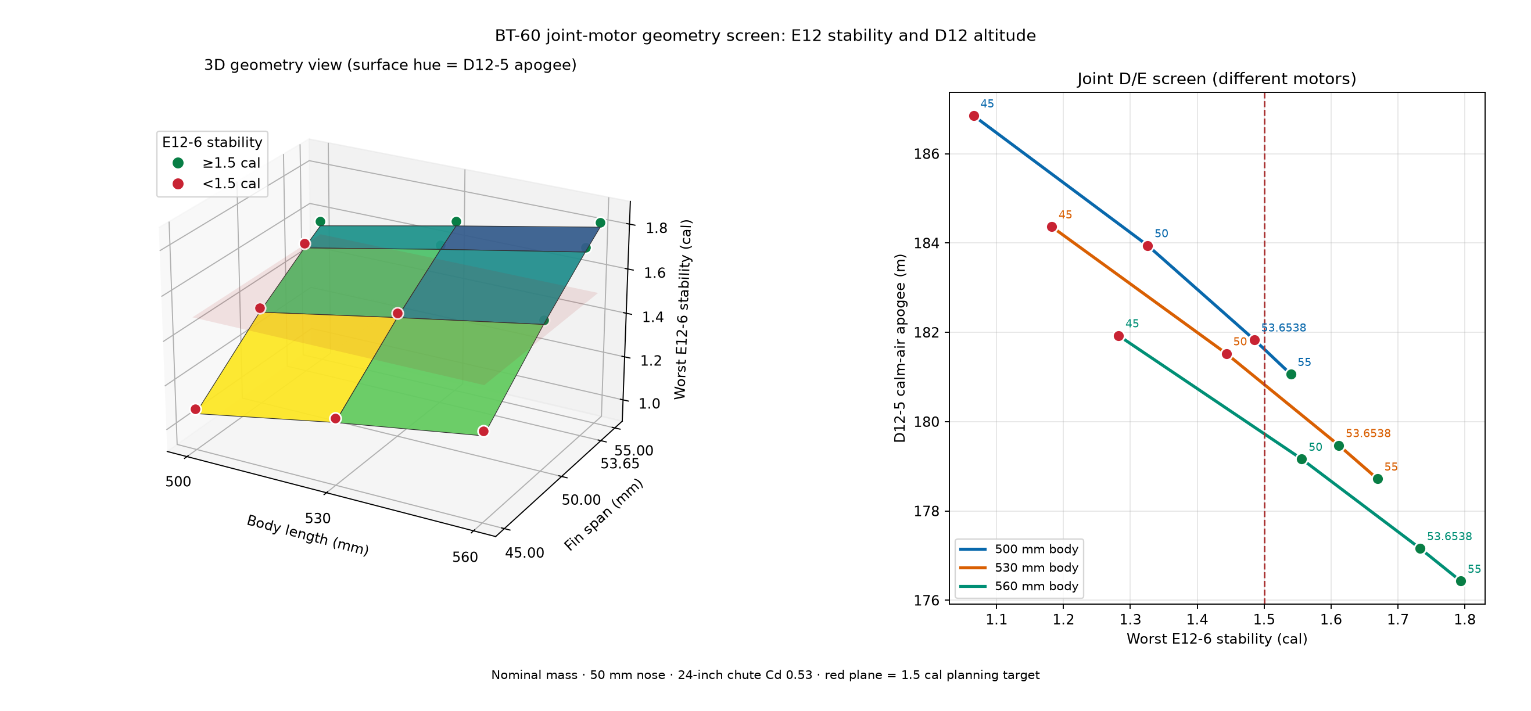
plots/de-geometry-surface.png
