BrentWilkins/rocket-workbench/plots/de-geometry-tradeoff.png

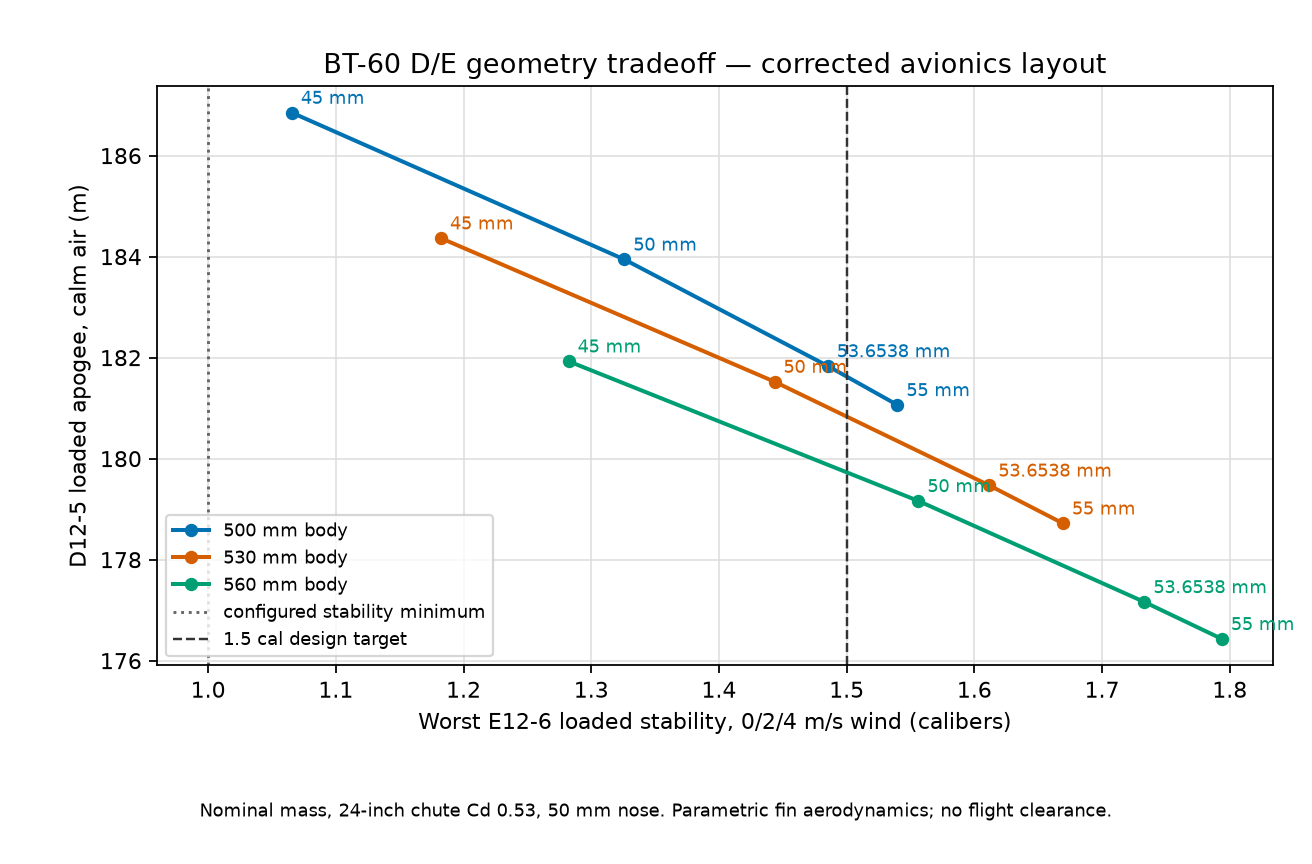
plots/de-geometry-tradeoff.png
