BrentWilkins/rocket-workbench/plots/ring-tail-comparison.png

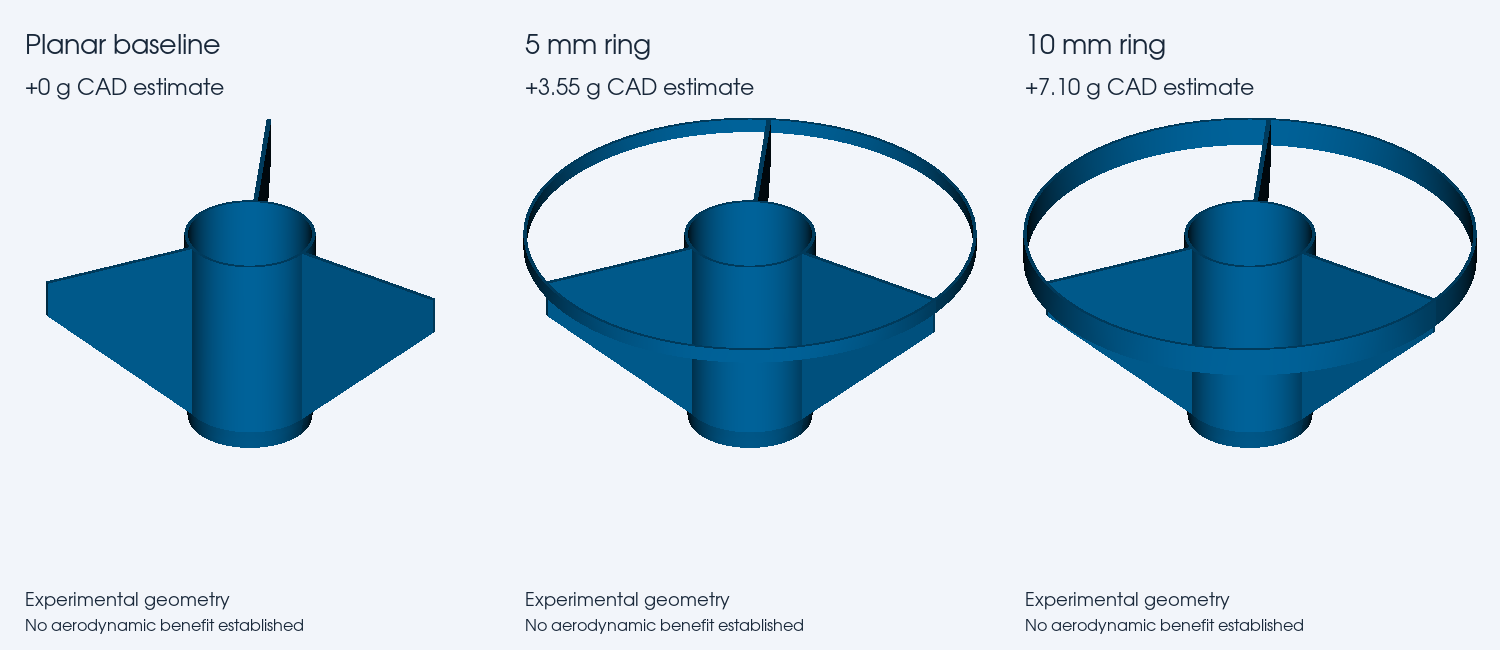
plots/ring-tail-comparison.png
