BrentWilkins/rocket-workbench/docs/assets/flight-robustness/flights.csv

phase | design | scenario | execution | warning_count | error | apogee_m | guide_departure_m_s | powered_min_stability_cal | minimum_ascent_stability_cal | powered_max_aoa_deg | burnout_tilt_deg | powered_max_pitch_yaw_rate_deg_s | deployment_speed_m_s | landing_displacement_m
deterministic | b500-n40-ogive-D12 | rod0.9144-wind0-heading0 | completed | 0 |  | 188.16396065363483 | 11.250998103175618 | 2.8095589329565893 | 2.2603660560675505 | 0.0009557095060873746 | 0.010082383562635916 | 0.0 | 0.7242327906039775 | 0.09250510230271908
deterministic | b500-n40-ogive-D12 | rod0.9144-wind2-heading0 | completed | 0 |  | 186.1290029987765 | 11.247290916465683 | 2.0848284426613093 | 2.0133507689629435 | 10.056926450072405 | 7.823043565495657 | 38.307771770064456 | 3.4531951192997306 | 48.86487700348473
deterministic | b500-n40-ogive-D12 | rod0.9144-wind2-heading90 | completed | 0 |  | 186.1317392318332 | 11.247290806386028 | 2.0848277757498592 | 2.018793266740356 | 10.05693860615839 | 7.83261863832892 | 38.31409565911605 | 3.471984146066718 | 48.780043124898235
deterministic | b500-n40-ogive-D12 | rod0.9144-wind4-heading0 | completed | 0 |  | 180.48514994898625 | 11.24655386676057 | 1.67107656248671 | 1.67107656248671 | 19.47368405740826 | 15.117752849744992 | 73.92346840367905 | 6.860411353194961 | 96.65441076142183
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
ensemble-20260919 | b500-n40-ogive-D12 | s20260919-0338 | completed | 0 |  | 170.78228780484946 | 11.104396415831324 | 1.674584417183063 | 1.674584417183063 | 17.564725143146784 | 13.696160128238356 | 67.82899728326035 | 6.84979392233036 | 67.33089152196456
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
