BrentWilkins/rocket-workbench/docs-evidence/runs/20260912T192553Z-candidate-recovery-7f53a228/cad/assembly.step

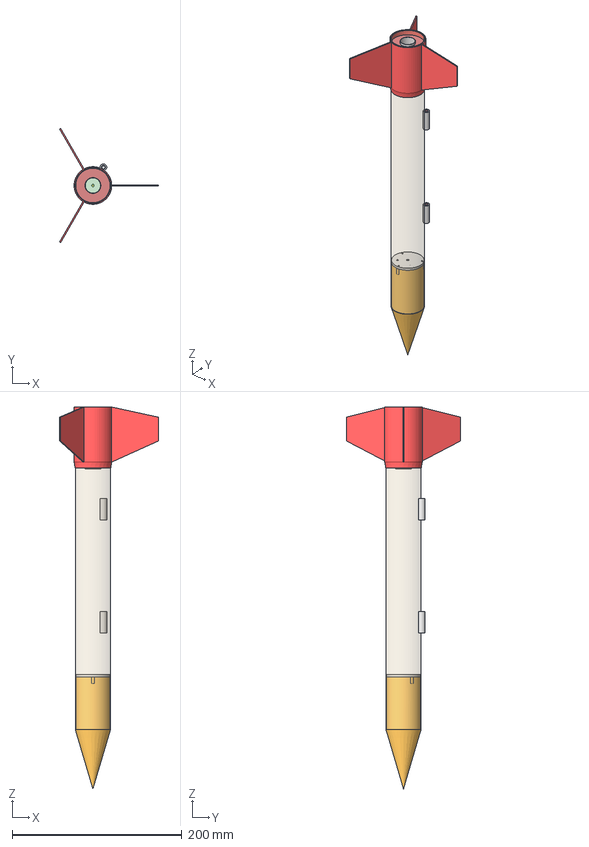
[picture p26: CAD file, 2026-09-12]
docs-evidence/runs/20260912T192553Z-candidate-recovery-7f53a228/cad/assembly.step
116.5 x 134.5 x 450.0 mm
nose-bay
bay-bulkhead
payload-sled
fin-collar
lug-sleeve-1
lug-sleeve-2
purchased-BT60
purchased-mount-envelope
purchased-centering-ring-envelope-0
purchased-centering-ring-envelope-1
packing-envelope-not-a-print
purchased-paper-lug-1
purchased-paper-lug-2
