BrentWilkins/rocket-workbench/docs-evidence/runs/avionics-geometry-20260913-corrected/ogive-n50-b440-f55/cad/assembly.step

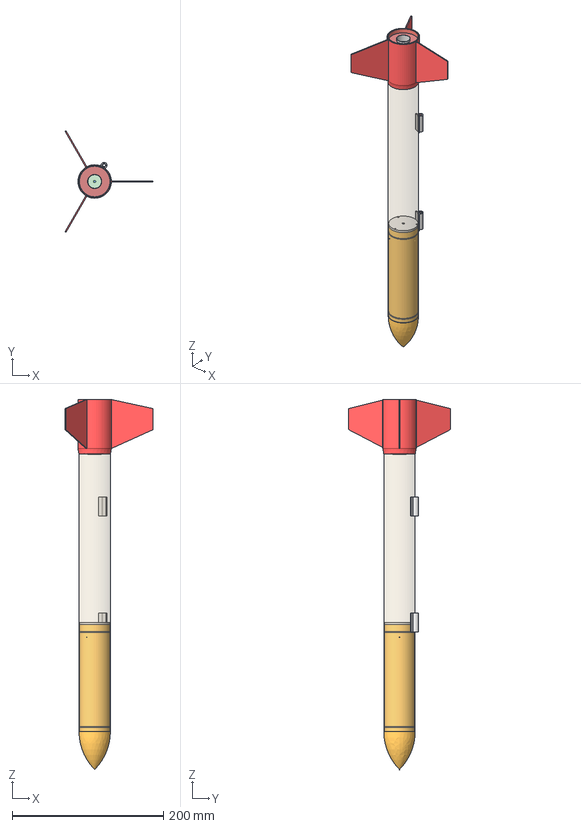
[picture p29: CAD file, 2026-09-13]
docs-evidence/runs/avionics-geometry-20260913-corrected/ogive-n50-b440-f55/cad/assembly.step
116.5 x 134.5 x 490.0 mm
nose-bay
bay-bulkhead
payload-sled
fin-collar
lug-sleeve-1
lug-sleeve-2
xiao-sense
l76k
antenna
battery
barometer
battery-connector
harness
retention
purchased-seal-envelope-0
purchased-seal-envelope-1
purchased-BT60
purchased-mount-envelope
purchased-centering-ring-envelope-0
purchased-centering-ring-envelope-1
packing-envelope-not-a-print
purchased-paper-lug-1
purchased-paper-lug-2
