BrentWilkins/rocket-workbench/docs/assets/tip-refinement-v3/cad/assembly.step

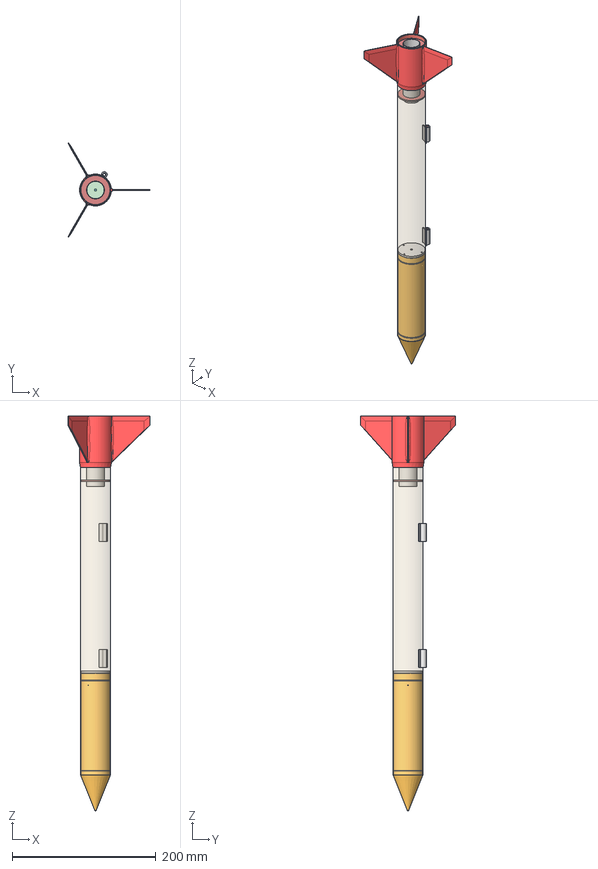
[picture p31: CAD file, 2026-09-20]
docs/assets/tip-refinement-v3/cad/assembly.step
114.1 x 131.7 x 550.0 mm
nose-bay
bay-bulkhead
payload-sled
fin-collar
lug-sleeve-1
lug-sleeve-2
xiao-sense
l76k
antenna
battery
barometer
battery-connector
harness
retention
purchased-seal-envelope-0
purchased-seal-envelope-1
purchased-BT60
purchased-mount-envelope
purchased-centering-ring-envelope-0
purchased-centering-ring-envelope-1
packing-envelope-not-a-print
purchased-paper-lug-1
purchased-paper-lug-2
