BrentWilkins/rocket-workbench/docs/assets/separate-fin-collar-v1/assembled-fit-reference.step

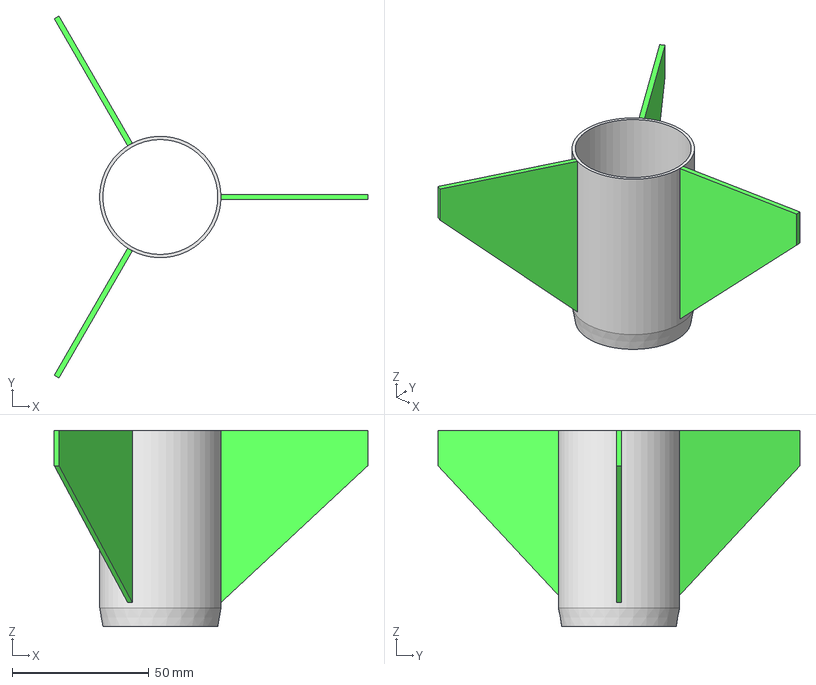
[picture p32: CAD file, 2026-09-20]
docs/assets/separate-fin-collar-v1/assembled-fit-reference.step
114.6 x 132.4 x 71.9 mm
round-collar
fin-0
fin-120
fin-240
