BrentWilkins/rocket-workbench/docs-evidence/prints/avionics-performance-v5.3mf

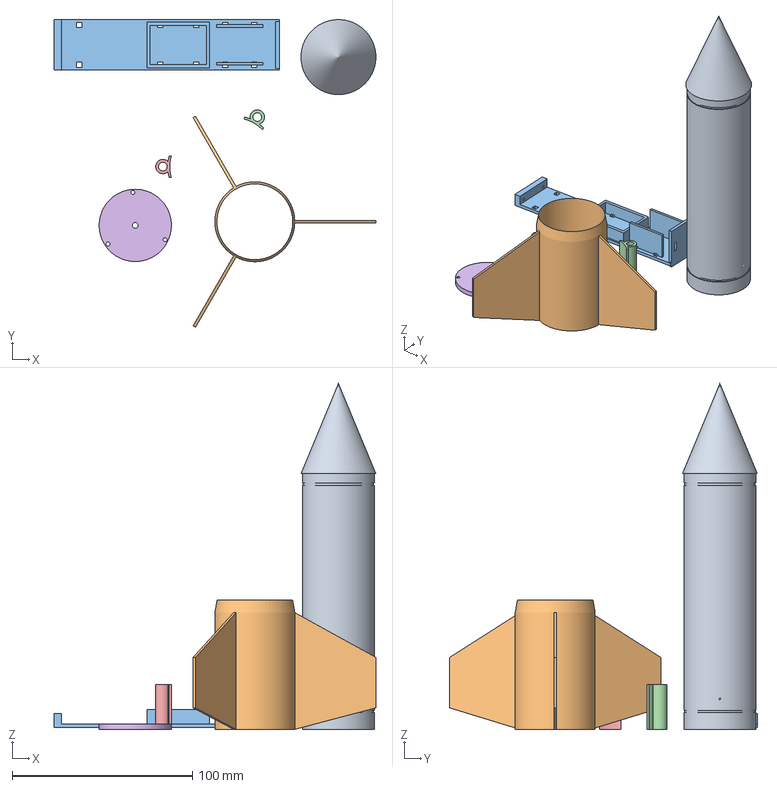
[picture p33: CAD file, 2026-09-13]
docs-evidence/prints/avionics-performance-v5.3mf
178.6 x 170.8 x 192.0 mm
nose-bay.stl
fin-collar.stl
payload-sled.stl
lug-sleeve-1.stl
lug-sleeve-2.stl
bay-bulkhead.stl
