BrentWilkins/rocket-workbench/docs-evidence/runs/20260912T224649Z-candidate-recovery-b6aebae0/cad/lug-sleeve-1.step

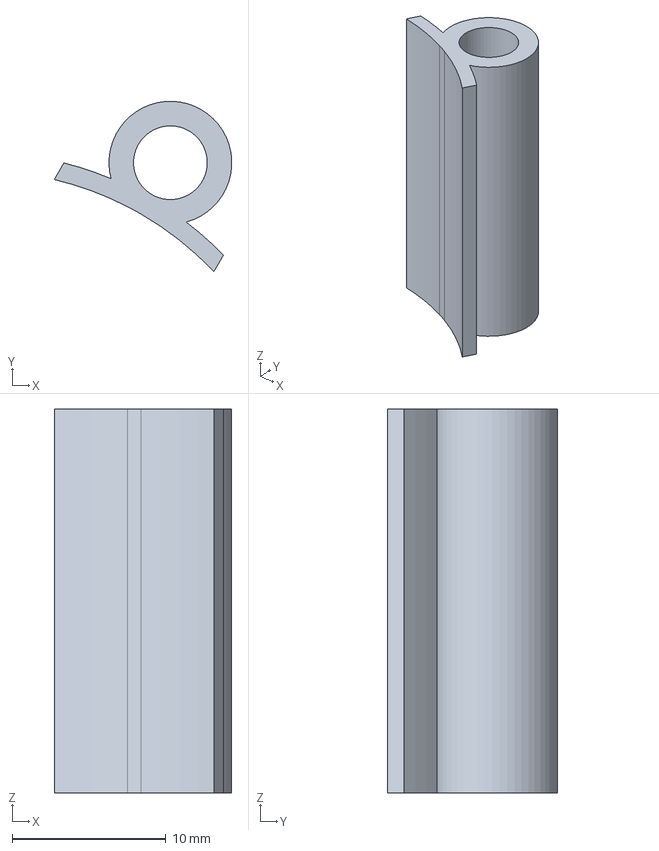
[picture p34: CAD file, 2026-09-12]
docs-evidence/runs/20260912T224649Z-candidate-recovery-b6aebae0/cad/lug-sleeve-1.step
11.6 x 11.1 x 25.0 mm
