BrentWilkins/rocket-workbench/docs-evidence/runs/avionics-selected-20260913/avionics-nominal/cad/avionics-keepouts.step

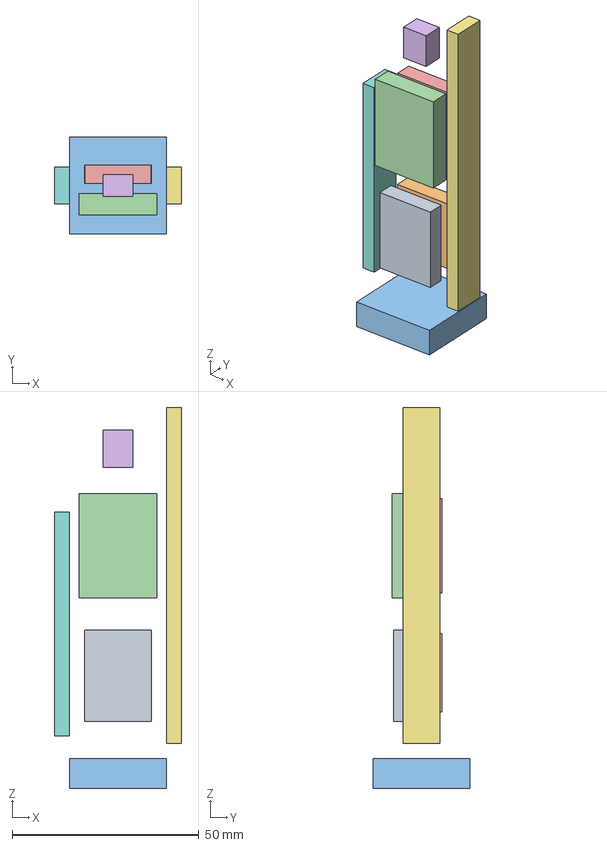
[picture p35: CAD file, 2026-09-13]
docs-evidence/runs/avionics-selected-20260913/avionics-nominal/cad/avionics-keepouts.step
34.0 x 26.0 x 102.0 mm
xiao-sense
l76k
antenna
battery
barometer
battery-connector
harness
retention
