BrentWilkins/rocket-workbench/docs/assets/fin-collar-v2/fin-collar-v2.step

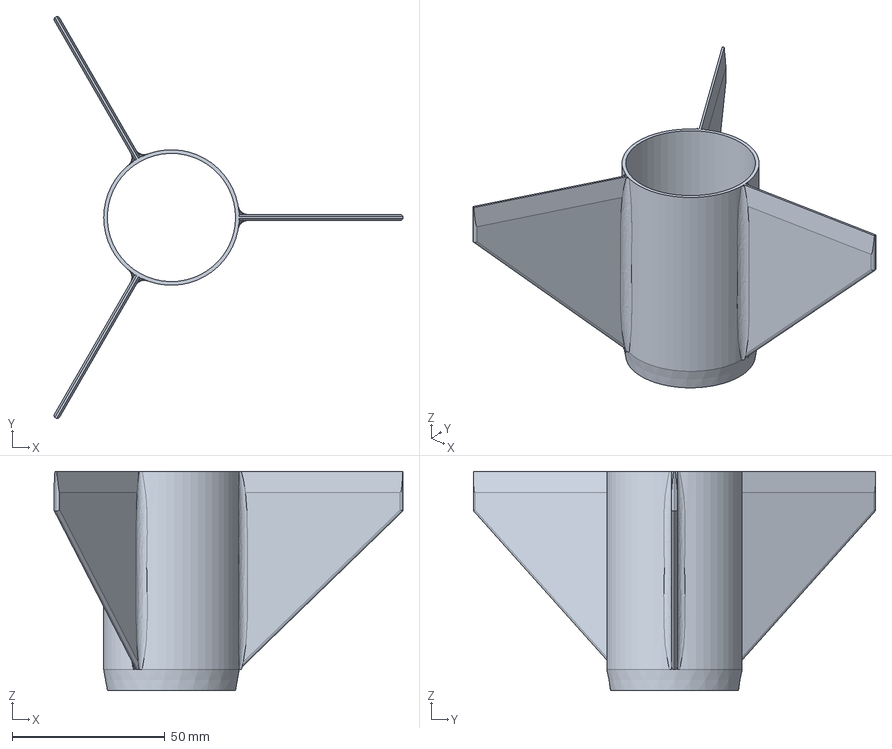
[picture p36: CAD file, 2026-09-17]
docs/assets/fin-collar-v2/fin-collar-v2.step
114.3 x 131.7 x 71.9 mm
