BrentWilkins/rocket-workbench/docs/assets/separate-fin-collar-v1/round-collar.step

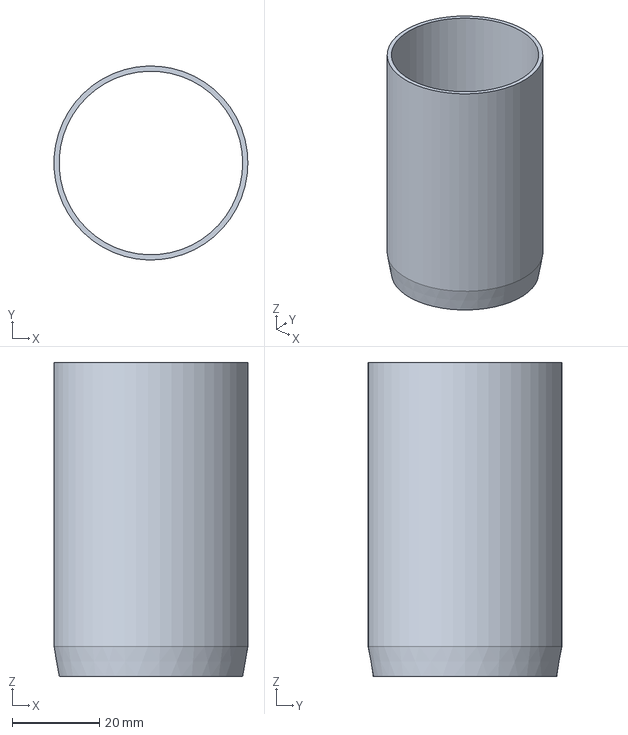
[picture p37: CAD file, 2026-09-20]
docs/assets/separate-fin-collar-v1/round-collar.step
44.4 x 44.4 x 71.9 mm
