BrentWilkins/rocket-workbench/docs/assets/tip-refinement-v3/cad/bay-bulkhead.stl

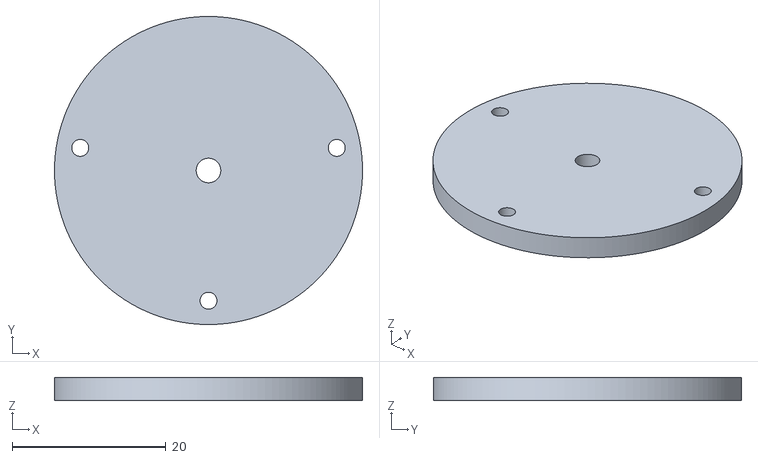
[picture p38: CAD file, 2026-09-20]
docs/assets/tip-refinement-v3/cad/bay-bulkhead.stl
40.1 x 40.1 x 3.00
