BrentWilkins/rocket-workbench/docs/assets/tip-refinement-v3/tip-refinement-X1C-review.3mf

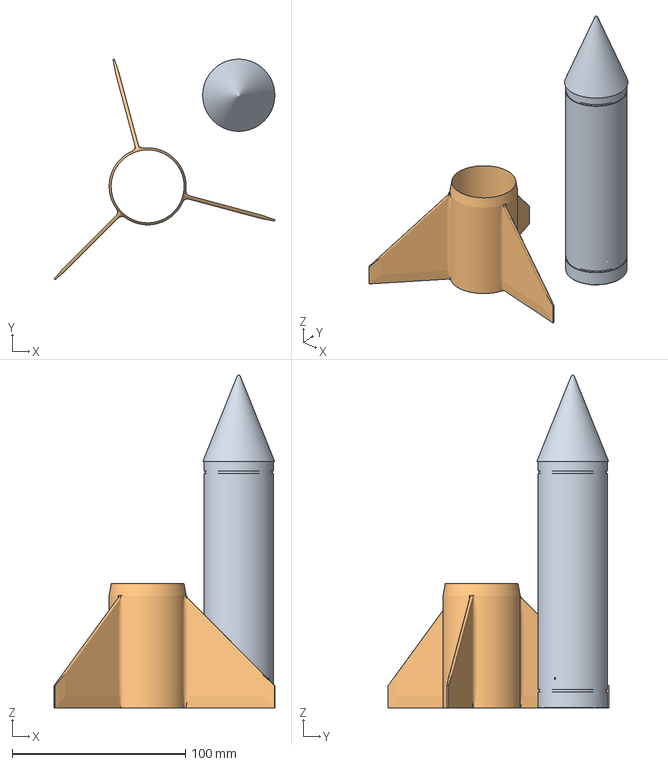
[picture p39: CAD file, 2026-09-20]
docs/assets/tip-refinement-v3/tip-refinement-X1C-review.3mf
127.2 x 127.2 x 192.0 mm
nose-bay.stl
fin-collar.stl
