BrentWilkins/rocket-workbench/docs-evidence/prints/rocket-fit-check-v3.3mf

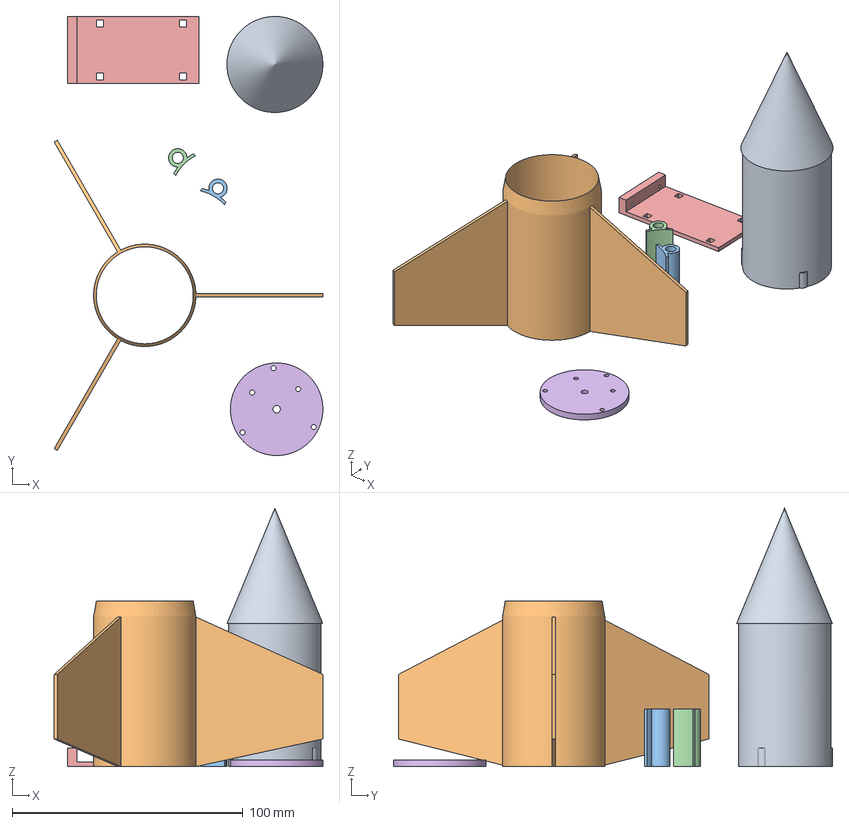
[picture p40: CAD file, 2026-09-12]
docs-evidence/prints/rocket-fit-check-v3.3mf
116.5 x 190.3 x 112.0 mm
nose-bay.stl
fin-collar.stl
lug-sleeve-1.stl
lug-sleeve-2.stl
payload-sled.stl
bay-bulkhead.stl
