BrentWilkins/rocket-workbench/docs/assets/separate-fin-collar-v1/separate-collar-three-fins-sliced.3mf

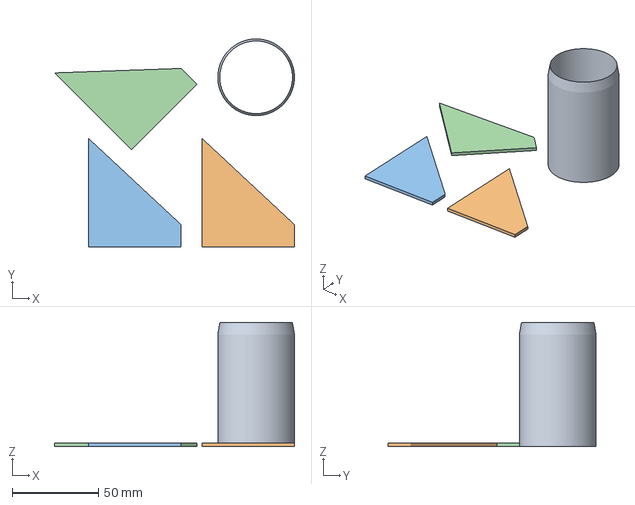
[picture p42: CAD file, 2026-09-20]
docs/assets/separate-fin-collar-v1/separate-collar-three-fins-sliced.3mf
138.9 x 120.5 x 71.9 mm
round-collar.stl
single-fin.stl x 3
