BrentWilkins/rocket-workbench/docs-evidence/runs/avionics-selected-20260913/avionics-nominal/cad/fin-collar.stl

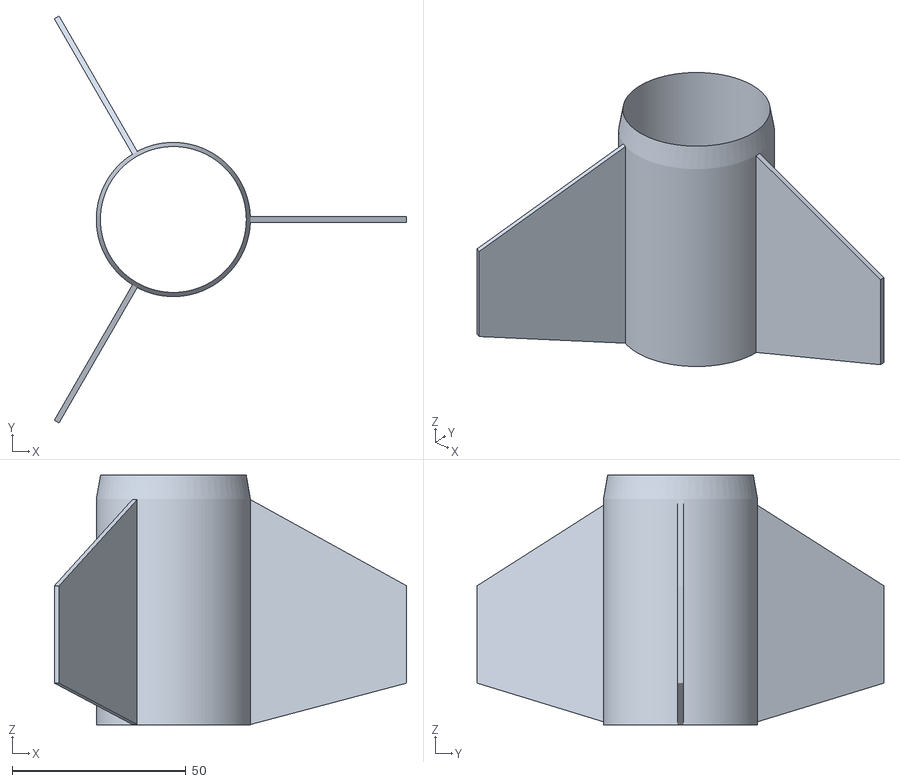
[picture p43: CAD file, 2026-09-13]
docs-evidence/runs/avionics-selected-20260913/avionics-nominal/cad/fin-collar.stl
101.5 x 117.2 x 71.9
