BrentWilkins/rocket-workbench/docs/assets/separate-fin-collar-v1/single-fin.step

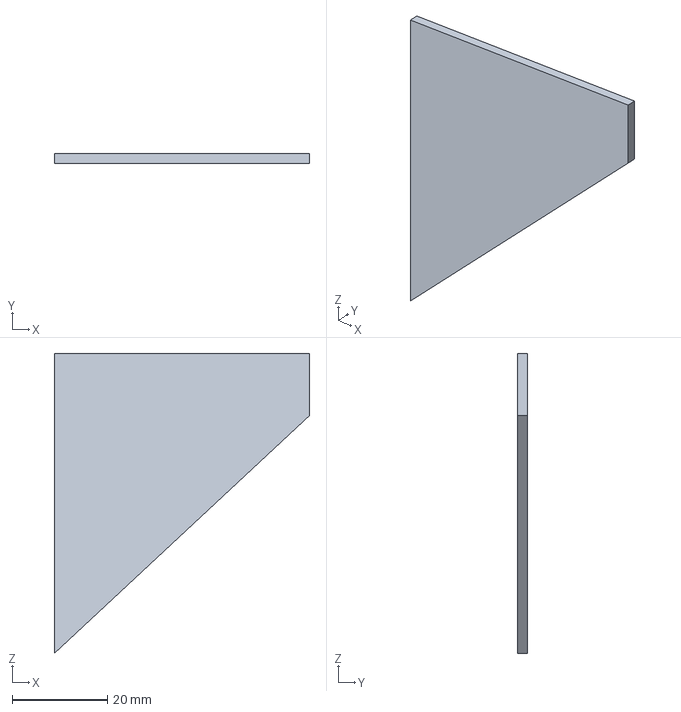
[picture p44: CAD file, 2026-09-20]
docs/assets/separate-fin-collar-v1/single-fin.step
53.7 x 2.00 x 63.0 mm
