BrentWilkins/rocket-workbench/docs/assets/tip-refinement-v3/cad/payload-sled.stl

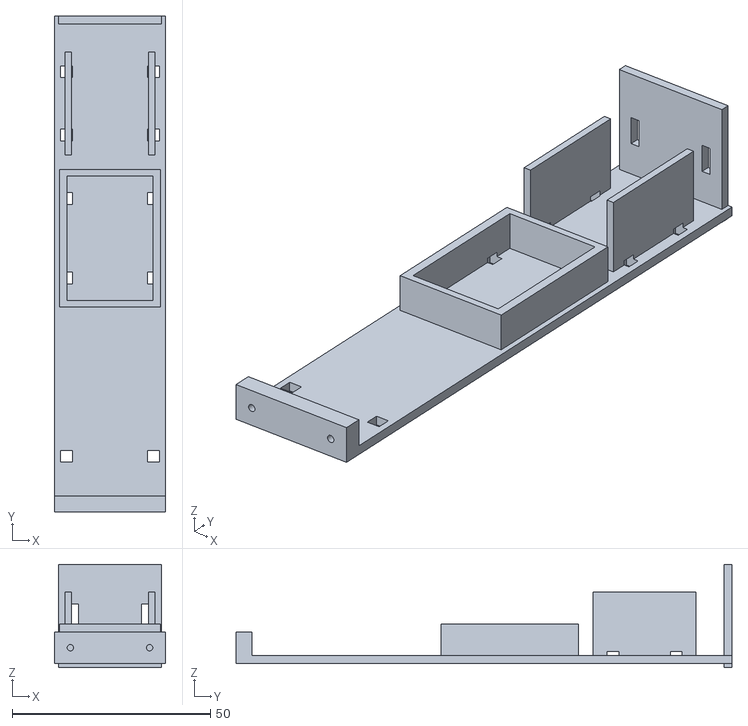
[picture p45: CAD file, 2026-09-20]
docs/assets/tip-refinement-v3/cad/payload-sled.stl
28.0 x 125.0 x 26.0
