BrentWilkins/rocket-workbench/docs-evidence/runs/avionics-selected-20260913/avionics-nominal/cad/avionics-installed.step

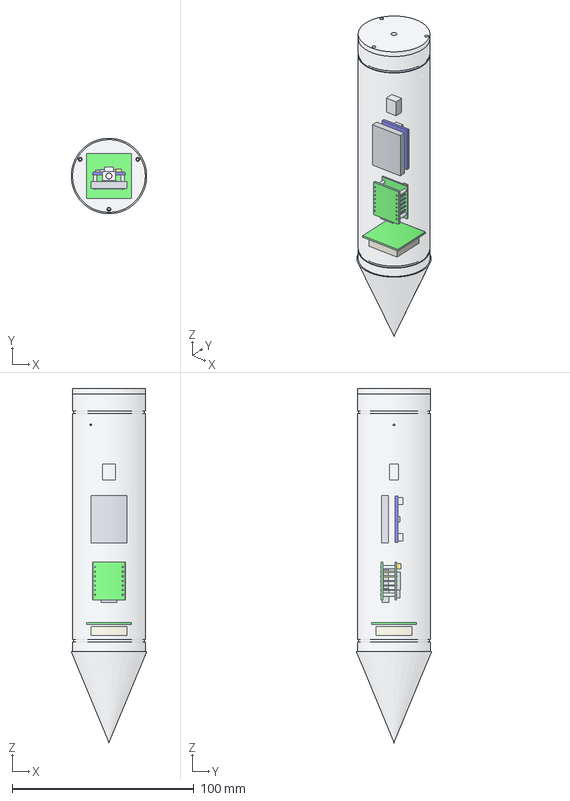
[picture p46: CAD file, 2026-09-13]
docs-evidence/runs/avionics-selected-20260913/avionics-nominal/cad/avionics-installed.step
41.6 x 41.6 x 195.0 mm
xiao-sense-0
xiao-sense-1
xiao-sense-2
l76k-0
l76k-1
l76k-2
l76k-3
barometer-0
barometer-1
barometer-2
barometer-3
barometer-4
antenna-0
antenna-1
battery-0
battery-connector-0
pin--1-0
spacer--1-0
pin--1-1
pin--1-2
pin--1-3
pin--1-4
pin--1-5
pin--1-6
spacer--1-6
pin-1-0
spacer-1-0
pin-1-1
pin-1-2
pin-1-3
pin-1-4
pin-1-5
pin-1-6
spacer-1-6
nose-bay
payload-sled
bay-bulkhead
