BrentWilkins/rocket-workbench/docs/assets/tip-refinement-v3/cad/nose-bay.step

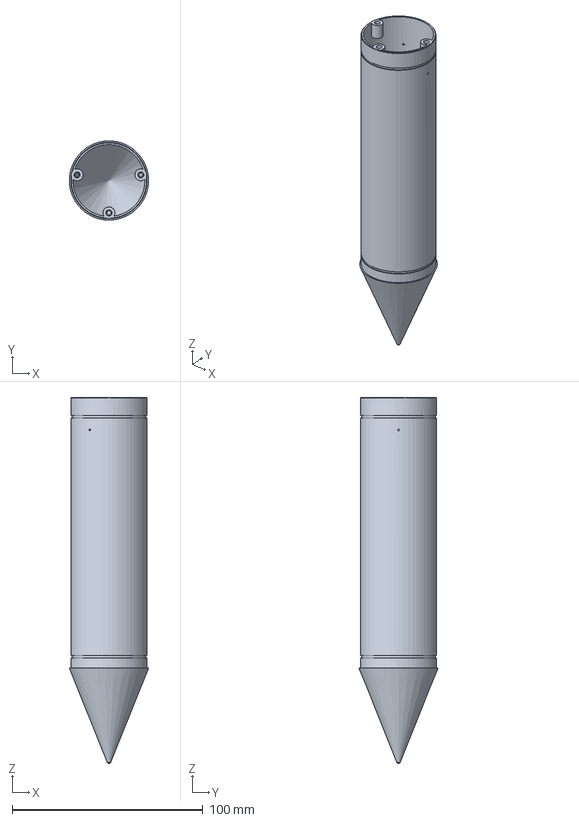
[picture p47: CAD file, 2026-09-20]
docs/assets/tip-refinement-v3/cad/nose-bay.step
41.6 x 41.6 x 192.0 mm
