BrentWilkins/rocket-workbench/docs-evidence/runs/avionics-selected-20260913/avionics-nominal/cad/nose-bay.step

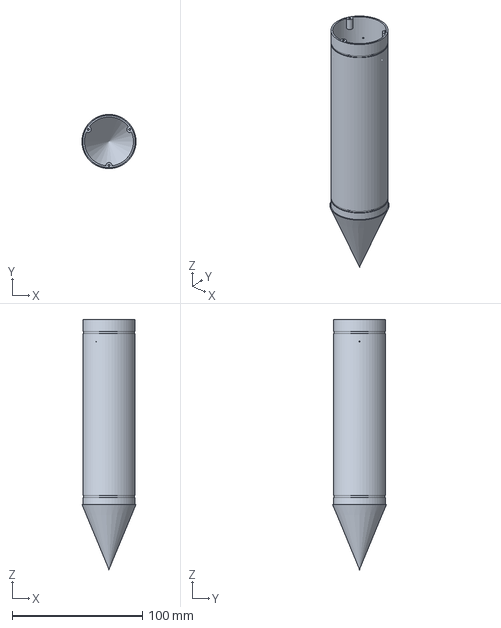
[picture p48: CAD file, 2026-09-13]
docs-evidence/runs/avionics-selected-20260913/avionics-nominal/cad/nose-bay.step
41.6 x 41.6 x 192.0 mm
