BrentWilkins/rocket-workbench/(list of files, cad)

Other CAD files:
docs-evidence/runs/motor24-bt60-20260913/bt60-24-e-nominal/cad/assembly.step
docs-evidence/runs/20260912T224649Z-candidate-recovery-b6aebae0/cad/assembly.step
docs-evidence/runs/avionics-selected-20260913/avionics-nominal/cad/assembly.step
docs/assets/fin-print-review-v5/fin-collar-review.3mf
docs/assets/fin-root-review-v4/fin-collar.step
docs/assets/integrated-fin-collar-v1/integrated-fin-collar-X1C-PLA-review.3mf
docs/assets/fin-print-review-v5/fin-collar.step
docs/assets/fin-root-review-v4/fin-collar-review.3mf
docs/assets/integrated-fin-collar-v1/collar-fins.step
docs/assets/tip-refinement-v3/sliced-tip-refinement-X1C.3mf
docs/assets/fin-print-review-v5/fin-collar-sliced.3mf
docs/assets/fin-root-review-v4/fin-collar-sliced.3mf
docs/assets/tip-refinement-v3/cad/fin-collar.step
docs-evidence/runs/avionics-selected-20260913/avionics-nominal/cad/bay-bulkhead.stl
docs/assets/separate-fin-collar-v1/separate-collar-three-fins.3mf
docs/assets/tip-refinement-v3/cad/lug-sleeve-1.stl
docs-evidence/runs/avionics-selected-20260913/avionics-nominal/cad/payload-sled.stl
docs/assets/tip-refinement-v3/cad/lug-sleeve-2.stl
docs-evidence/runs/avionics-selected-20260913/avionics-nominal/cad/lug-sleeve-1.stl
docs-evidence/runs/avionics-selected-20260913/avionics-nominal/cad/lug-sleeve-2.stl
docs-evidence/runs/avionics-selected-20260913/avionics-nominal/cad/nose-bay.stl
docs-evidence/runs/nose-study-20260912T225633Z/nose-conical-50/cad/nose-bay.step
docs-evidence/runs/nose-study-20260912T225633Z/nose-conical-50/cad/nose-bay.stl
docs/assets/fin-collar-v2/fin-collar-v2.stl
docs/assets/fin-print-review-v5/fin-collar.stl
docs/assets/fin-root-review-v4/fin-collar.stl
docs/assets/integrated-fin-collar-v1/collar-fins.f3d
docs/assets/integrated-fin-collar-v1/collar-fins.stl
docs/assets/separate-fin-collar-v1/round-collar.stl
docs/assets/separate-fin-collar-v1/single-fin.stl
docs/assets/tip-refinement-v3/cad/fin-collar.stl
docs/assets/tip-refinement-v3/cad/nose-bay.stl
