BrentWilkins/rocket-workbench/docs/assets/avionics/installed-cutaway.png

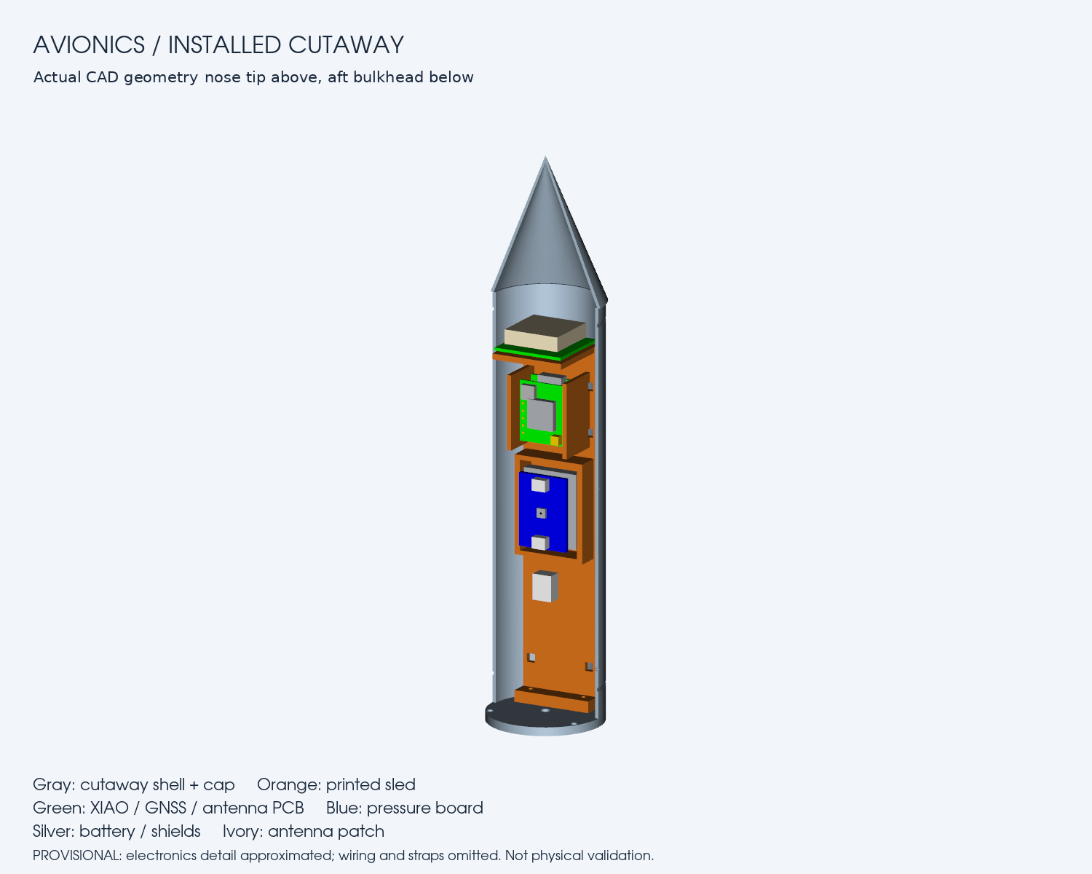
docs/assets/avionics/installed-cutaway.png
