BrentWilkins/rocket-workbench/docs-evidence/runs/avionics-selected-20260913/avionics-upper-mass/results.csv

case | execution | evaluation | apogee_m | guide_departure_m_s | minimum_ascent_stability_cal | deployment_speed_m_s | landing_descent_m_s | landing_displacement_m | peak_powered_acceleration_g | peak_powered_specific_force_estimate_g | peak_powered_speed_m_s
empty-A8-3-wind0 | completed | outside configured limits | 7.688653494540828 | 6.84208495417975 | 1.7634733807760201 |  | 11.247667727037735 | 0.3232319612055395 | 5.542146748549443 | 6.54113991277844 | 8.835482439587741
empty-A8-3-wind2 | completed | outside configured limits | 7.6554417146883305 | 6.834724745970673 | 0.7412528569920422 |  | 10.625846032963135 | 0.5768977284641994 | 5.538714699930132 | 6.537707864162943 | 8.809429942501716
empty-B4-4-wind0 | completed | outside configured limits | 26.740331677734343 | 8.58962243258586 | 1.5810474773627434 | 14.3724572149061 | 4.7667151268594665 | 3.1228682549073947 | 7.416940458097692 | 8.415933657160034 | 17.905760934309093
empty-B4-4-wind2 | completed | outside configured limits | 25.993492381266602 | 8.581700258062488 | 0.772805788082242 | 14.822256069982515 | 4.764980421489373 | 5.33575599900861 | 7.414760910592051 | 8.413754109654851 | 17.680624041677564
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
