BrentWilkins/rocket-workbench/docs-evidence/runs/powered-study-20260913T012040Z/nominal/results.csv

case | execution | evaluation | apogee_m | guide_departure_m_s | minimum_ascent_stability_cal | deployment_speed_m_s | landing_descent_m_s | landing_displacement_m | peak_powered_acceleration_g | peak_powered_specific_force_estimate_g | peak_powered_speed_m_s
empty-A8-3-wind0 | completed | outside configured limits | 11.15477994720002 | 8.128798352271614 | 1.7489181307338393 |  | 11.19994514303345 | 0.815433949698167 | 6.670559717750727 | 7.669552863184476 | 11.343015154113811
empty-A8-3-wind2 | completed | outside configured limits | 11.004022328582218 | 8.119341931649707 | 0.8440561196636488 |  | 11.290608346433524 | 0.5101604708829451 | 6.664506633538873 | 7.663499778982879 | 11.288732687608638
empty-B4-4-wind0 | completed | outside configured limits | 36.81380203287855 | 9.936661114941419 | 1.7016949225058318 | 11.542676007364925 | 4.3942186392113465 | 1.0544109972942854 | 8.84026625524788 | 9.839259445913907 | 22.273652138877623
empty-B4-4-wind2 | completed | outside configured limits | 35.88002064279413 | 9.927056367075027 | 1.002490871214925 | 16.10303628231713 | 4.3941685544086475 | 2.0426511654182544 | 8.836286058997539 | 9.83527924966523 | 22.064958628569833
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
