BrentWilkins/rocket-workbench/scripts/cfd_naca0012_force_audit.py

"""Audit NACA 0012 force history, conditions, symmetry, and settling fail-closed."""

import argparse
import hashlib
import json
import re
from pathlib import Path

import numpy as np

from cfd_naca0012_ladson_reference import OUTPUT_NAME, PDF_SHA256


IMAGE_ID = "sha256:143e0e81aa690349714910f096ef1a2dc5fbc723a27355f5078839503a9b7634"
SUTHERLAND_PR_IMAGE_ID = "sha256:2870176815d77d1b6e252003db8f7598f2bb25e891c7ea97ec459e469b54d020"
SSTM_K_ONLY_LIMITER_IMAGE_ID = "sha256:777e5ff0348eab1026f69bfe7fd2a01685d250a6a186a674a9bdc0e83ff7ef8b"
SSTM_EXACT_PRODUCTION_IMAGE_ID = "sha256:ae3235d75b54311a6dbcdfc2b45f6c9be77a8ff0743c099cf5ca3f3e9db0d23f"
CFL3D_FORCE_SHA256 = "373dc142018816628b7b53ad278327db731162988ba35a166cd9fdc131a7fd7a"


def mapped_initialization_gate(case: Path, spec: dict) -> bool:
    initialization = spec.get("initialization", {})
    method = initialization.get("method")
    if method in {
        "same-grid higher-to-first-order scheme-sensitivity restart",
        "same-grid scheme-sensitivity restart",
        "same-grid tmr-sstm-to-stock-komega-sst sensitivity restart",
        "same-grid polynomial-Sutherland constant-Prandtl sensitivity restart",
            "same-grid exact-Sutherland constant-Prandtl sensitivity restart",
            "same-grid SSTm k-only production-limiter sensitivity restart",
            "same-grid SSTm exact-production sensitivity restart",
            "same-grid SSTm exact-production residual convergence continuation",
            "449x129 exact-transport exact-SSTm numerical-refresh restart",
            "same-grid exact-SSTm LUST numerical-refresh restart",
            "same-grid exact-SSTm exact-wall-distance sensitivity restart",
            "structured retained-row full-to-reduced-domain restart",
    }:
        try:
            if method == "same-grid tmr-sstm-to-stock-komega-sst sensitivity restart":
                record_name = "model-restart-execution.json"
            elif method == "same-grid polynomial-Sutherland constant-Prandtl sensitivity restart":
                record_name = "transport-restart-execution.json"
            elif method == "same-grid exact-Sutherland constant-Prandtl sensitivity restart":
                record_name = "sutherland-pr-restart-execution.json"
            elif method == "same-grid SSTm k-only production-limiter sensitivity restart":
                record_name = "sstm-limiter-restart-execution.json"
            elif method == "same-grid SSTm exact-production sensitivity restart":
                record_name = "sstm-exact-production-restart-execution.json"
            elif method == (
                "same-grid SSTm exact-production residual convergence continuation"
            ):
                record_name = "sstm-exact-production-continuation-execution.json"
            elif method == "449x129 exact-transport exact-SSTm numerical-refresh restart":
                record_name = "exact-sstm-medium-restart-execution.json"
            elif method == "same-grid exact-SSTm LUST numerical-refresh restart":
                record_name = "exact-sstm-lust-restart-execution.json"
            elif method == (
                "same-grid exact-SSTm exact-wall-distance sensitivity restart"
            ):
                record_name = "exact-wall-distance-restart-execution.json"
            elif method == "structured retained-row full-to-reduced-domain restart":
                record_name = "domain-restart-execution.json"
            else:
                record_name = "scheme-restart-execution.json"
            record = json.loads((case / record_name).read_text())
            snapshot = Path(initialization["implementation_snapshot"])
            implementation_digest = hashlib.sha256(snapshot.read_bytes()).hexdigest()
            audit_path = Path(initialization["source_audit"])
            audit_digest = hashlib.sha256(audit_path.read_bytes()).hexdigest()
            source_audit = json.loads(audit_path.read_text())
            fields_match = all(
                hashlib.sha256((case / "0" / name).read_bytes()).hexdigest()
                == metadata["restart_sha256"]
                for name, metadata in initialization["fields"].items()
            )
            return (
                record.get("stage_passed") is True
                and record.get("implementation_sha256") == implementation_digest
                and initialization.get("implementation_sha256") == implementation_digest
                and initialization.get("source_audit_sha256") == audit_digest
                and source_audit.get("coarse_preflight_passed") is True
                and fields_match
            )
        except (OSError, KeyError, TypeError, ValueError, json.JSONDecodeError):
            return False
    if method != "structured bilinear logical-coordinate prolongation":
        return True
    try:
        record = json.loads((case / "map-fields-execution.json").read_text())
        implementation = Path(__file__).with_name("cfd_naca0012_map_fields.py")
        implementation_digest = hashlib.sha256(implementation.read_bytes()).hexdigest()
        audit_path = Path(initialization["source_audit"])
        audit_digest = hashlib.sha256(audit_path.read_bytes()).hexdigest()
        source_audit = json.loads(audit_path.read_text())
        fields_match = all(
            hashlib.sha256((case / "0" / name).read_bytes()).hexdigest()
            == metadata["mapped_sha256"]
            for name, metadata in initialization["fields"].items()
        )
        return (
            record.get("stage_passed") is True
            and record.get("implementation_sha256") == implementation_digest
            and initialization.get("implementation_sha256") == implementation_digest
            and initialization.get("source_audit_sha256") == audit_digest
            and source_audit.get("coarse_preflight_passed") is True
            and fields_match
        )
    except (OSError, KeyError, TypeError, ValueError, json.JSONDecodeError):
        return False


def coefficient_files(case: Path) -> list[Path]:
    files = sorted((case / "postProcessing" / "coefficients").glob("*/coefficient.dat"))
    if not files:
        files = sorted(
            (case / "postProcessing" / "coefficients").glob("*/forceCoeffs.dat")
        )
    return files


def coefficient_history(case: Path) -> tuple[list[str], np.ndarray]:
    files = coefficient_files(case)
    if len(files) != 1:
        raise ValueError(f"Expected one force coefficient history, got {len(files)}")
    header = next(
        line for line in files[0].read_text().splitlines() if line.startswith("# Time ")
    )
    columns = header.removeprefix("# ").split()
    columns = ["CmPitch" if column == "Cm" else column for column in columns]
    values = np.loadtxt(files[0])
    if values.ndim == 1:
        values = values[None, :]
    if values.shape[1] != len(columns):
        raise ValueError("Force coefficient columns do not match header")
    return columns, values


def coefficient_header_vector(case: Path, label: str) -> list[float]:
    files = coefficient_files(case)
    if len(files) != 1:
        raise ValueError(f"Expected one force coefficient file, found {len(files)}")
    pattern = re.compile(rf"^#\s*{re.escape(label)}\s*:\s*\(([^)]+)\)")
    for line in files[0].read_text().splitlines():
        match = pattern.match(line)
        if match:
            values = [float(value) for value in match.group(1).split()]
            if len(values) == 3:
                return values
            break
    raise ValueError(f"Missing three-component {label} header")


def experimental_points(path: Path, angle: float) -> dict:
    rows = []
    for line in path.read_text().splitlines():
        values = line.split()
        if len(values) != 3:
            continue
        try:
            alpha, cl, cd = map(float, values)
        except ValueError:
            continue
        if abs(alpha - angle) <= 0.2:
            rows.append((alpha, cl, cd))
    if len(rows) < 2:
        raise ValueError(f"Insufficient Ladson repeat points near {angle} degrees")
    data = np.asarray(rows)
    return {
        "points": data.tolist(),
        "angle_window_deg": 0.2,
        "mean_angle_deg": float(data[:, 0].mean()),
        "mean_cl": float(data[:, 1].mean()),
        "mean_cd": float(data[:, 2].mean()),
        "cl_range": float(np.ptp(data[:, 1])),
        "cd_range": float(np.ptp(data[:, 2])),
    }


def cfl3d_reference(path: Path, angle: float) -> dict:
    if hashlib.sha256(path.read_bytes()).hexdigest() != CFL3D_FORCE_SHA256:
        raise ValueError("CFL3D force reference missing or wrong SHA-256")
    rows = []
    for line in path.read_text().splitlines():
        values = line.split()
        if len(values) != 3:
            continue
        try:
            alpha, cl, cd = map(float, values)
        except ValueError:
            continue
        if abs(alpha - angle) <= 0.2:
            rows.append((alpha, cl, cd))
    if len(rows) != 1:
        raise ValueError(f"Expected one CFL3D reference point near {angle} degrees")
    alpha, cl, cd = rows[0]
    return {"angle_deg": alpha, "cl": cl, "cd": cd}


def experimental_moment(path: Path, angle: float) -> dict:
    reference = json.loads(path.read_text())
    source_pdf = path.parent / "nasa-tm-4074.pdf"
    if hashlib.sha256(source_pdf.read_bytes()).hexdigest() != PDF_SHA256:
        raise ValueError("NASA TM-4074 PDF is missing or has the wrong SHA-256")
    rows = [
        row for row in reference["rows"] if abs(row["alpha_deg"] - angle) <= 0.2
    ]
    if len(rows) < 2:
        raise ValueError(f"Insufficient Ladson moment points near {angle} degrees")
    values = np.asarray([row["cm_quarter_chord_nose_up"] for row in rows])
    return {
        "points": rows,
        "angle_window_deg": 0.2,
        "mean_cm_quarter_chord_nose_up": float(values.mean()),
        "cm_range": float(np.ptp(values)),
        "source_pdf_sha256": PDF_SHA256,
    }


def long_window_trend(
    values: np.ndarray,
    indices: dict[str, int],
    angle_deg: float,
    window: int,
) -> tuple[dict[str, float], dict[str, float], bool]:
    """Project force drift over a long window against repeatability limits."""
    if len(values) < window:
        raise ValueError(f"Need at least {window} force samples")
    trend = values[-window:]
    trend_x = trend[:, indices["Time"]]
    projected = {
        name: abs(float(np.polyfit(trend_x, trend[:, indices[name]], 1)[0]) * window)
        for name in ("Cd", "Cl", "CmPitch")
    }
    alpha = np.radians(angle_deg)
    limits = {
        "Cd": 0.0002,
        "Cl": 0.004 * abs(float(np.cos(alpha)))
        + 0.0002 * abs(float(np.sin(alpha))),
        "CmPitch": 0.0002,
    }
    return projected, limits, all(projected[name] <= limits[name] for name in projected)


def solver_residual_gate(
    log: str, window: int = 100
) -> tuple[dict[str, float], dict[str, float], bool]:
    fields = ("p", "Ux", "Uy", "e", "omega", "k")
    histories = {name: [] for name in fields}
    pattern = re.compile(
        r"Solving (?:for )?(p|Ux|Uy|e|omega|k), Initial residual = "
        r"([0-9.eE+-]+)"
    )
    for name, value in pattern.findall(log):
        histories[name].append(float(value))
    missing = [name for name, values in histories.items() if len(values) < window]
    if missing:
        raise ValueError(f"Need at least {window} residual samples for {missing}")
    final = {name: values[-1] for name, values in histories.items()}
    recent_max = {name: max(values[-window:]) for name, values in histories.items()}
    gate = all(value <= 1e-5 for value in final.values()) and all(
        value <= 1e-4 for value in recent_max.values()
    )
    return final, recent_max, gate
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
