BrentWilkins/rocket-workbench/scripts/cfd_naca0012_gradient_audit.py

"""Compare limited and unlimited OpenFOAM velocity gradients on a sealed solution."""

from __future__ import annotations

import argparse
import json
import os
import re
import shutil
import subprocess
import tempfile
from pathlib import Path

import numpy as np

from cfd_naca0012_farfield_audit import latest_time, mesh_geometry, sha256
from cfd_naca0012_surface_force_audit import internal_scalar, patch_owners


LIMITED_GRADIENT = "grad(U) $limited;"
UNLIMITED_GRADIENT = "grad(U) Gauss linear;"


def internal_tensor(path: Path) -> np.ndarray:
    match = re.search(
        r"\binternalField\s+nonuniform\s+List<tensor>\s+(\d+)\s*"
        r"\(\s*(.*?)\s*\)\s*;",
        path.read_text(),
        re.DOTALL,
    )
    if not match:
        raise ValueError(f"Missing nonuniform internal tensor field in {path}")
    values = np.asarray(
        [
            [float(value) for value in row.split()]
            for row in re.findall(r"\(([^()]*)\)", match.group(2))
        ],
        dtype=float,
    )
    if values.shape != (int(match.group(1)), 9) or not np.all(np.isfinite(values)):
        raise ValueError(f"Malformed internal tensor field in {path}")
    return values.reshape(-1, 3, 3)


def image_identity(image: str) -> dict:
    return json.loads(
        subprocess.check_output(["docker", "image", "inspect", image], text=True)
    )[0]
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
