BrentWilkins/rocket-workbench/(commit log)

2026-09-12 feat: add reproducible rocket workbench and documentation site
    [assembly.step]
2026-09-12 feat: compare nose profiles and validate print orientations
    [assembly.step, lug-sleeve-1.step, lug-sleeve-1.stl, nose-bay.step, nose-bay.stl, rocket-fit-check-v3.3mf]
2026-09-13 feat: publish corrected avionics performance and uncertainty studies
    [assembly.step, avionics-detailed.step, avionics-installed.step, avionics-keepouts.step, avionics-performance-v5.3mf, bay-bulkhead.stl, fin-collar.stl, lug-sleeve-1.stl]
2026-09-13 docs: publish motor fin and recovery study checkpoint
    [assembly.step, comparison.csv]
2026-09-13 docs: publish expanded recovery shortlist and geometry trials
    [prepare_docs.py]
2026-09-13 feat: integrate insert-bay review and updated D12 evidence
2026-09-14 fix(cfd): make solver environment independent of image tag
    [cfd_run.py]
2026-09-17 Add organic fin collar v2 and refresh docs
    [fin-collar-v2.step, fin-collar-v2.stl]
2026-09-20 Record current BT-60 design and verification baseline
    [assembled-fit-reference.step, assembly.step, bay-bulkhead.stl, collar-fins.f3d, collar-fins.step, collar-fins.stl, fin-collar-review.3mf, fin-collar-sliced.3mf]
2026-09-20 Publish flight robustness study and current design recommendation
    [c11-mass-screen.csv, flights.csv, nominal-grid.csv, root-chord-sensitivity.csv, stabilization.csv, upper-mass-sensitivity.csv]
2026-09-21 Swap avionics IMU to ICM-20649 and record the placed order
    Replace the EOL LIS331HH with the Adafruit ICM-20649 across the avionics
    design, firmware design, CAD component table and study script. The new part
    is 16-bit at 0.98 mg/LSB on a wider +/-30 g range and adds a gyro.
    Two documented rates were not selectable on the new part: the ODR derives
    from 1125 Hz over an integer divider, so 375 Hz replaces 400 Hz, and the
    pad range-switching routine is dropped as unnecessary at the new resolution.
    Bus loading recomputed at 58 kbit/s.
    Add the verified DigiKey order to the shopping list with the parts that need
    weighing on arrival; board envelope and mass remain allowances.
    [avionics.py, study_avionics.py]
